Aarhus-University-MPE/ArcticRover/(threads)

Thread 1 (2022-06-20):

Battery Overheated/Chemical Smell

MadsR, 2022-06-20:
### ArcticRover firmware version

0.97.037

### Area(s) with issue?

Hardware Issue, Batteries

### Steps to reproduce

Rover was hot, heating element was disconnected.
Tried maneuvering rover with remote control, unresponsive, assumed low battery.
Left Rover in the sun throughout day, to presumably charge batteries.
Returned later in the day, batteries hot, and a chemical smell inside the box.

### ✔️ Expected Behavior

_No response_

### ❌ Actual Behavior

_No response_

grinsted, 2022-06-23:
Would an off the shelf solar charge controller prevent the issue in future?

MadsR, 2022-06-24:
**Solar Charge Controller**
Any controller capable to handling "single cell" charging should suffice.
Regualr LiPo chargers require individual cell measurements to charge.

Battery manufacturer stated that such a Battery Management System (BMS) would not at all be necessary, and could in worst case make the system perform worse (efficiency, etc.).

This primary error would not happen if the Rover was active (move until low battery -> halt until high -> move until low).
This is only due to having full capactiy and continuously charging.

---

**Potential Solution 1**
Add external power draw (power resistor) once batteries reach 100%, to avoid overcharging batteries.

**Notes**
Power Resistor has to be dimensioned sufficiently to not overheat.
Can be used as a means of 'clearing snow' around Rover while idle.

---

**Potential Solution 2**
Add Solar Charge Controller..

**Notes**
As stated can potentially reduce efficiency.

---

**Potential Solution 3**
Wire solar panels through ON/OFF switch, to avoid charging batteries while system is Idle

**Notes**
Can cause solar panels to overheat as well if they have no way to dissipate generated power.  (Add bypass Power Resistor when disconnected)

grinsted, 2022-07-05:
We configured a morningstar TS-45 to work with the NiMH voltages we used. This has resolved the issue. The configuration should be optimized for the cells.

Thoughts: The morningstar can be configured to dump excess solar energy into a dump load that could heat the interior. (We did not do this as it would probably get too hot unless there is some temperature control too.

Potential issue: NiMH cells have a very flat voltage vs charge% curve. This makes it more important to allow for temperature effects on all voltage thresholds. -Both those configured in the charge controller, but perhaps also those in the arduino code.

Thread 2 (2022-06-24):

Motor Error 20 & 28

MadsR, 2022-06-24:
### ArcticRover firmware version

0.97.07

### Area(s) with issue?

Hardware Issue

### Steps to reproduce

Enable motor driver power, Enable motor Primary power.

### ✔️ Expected Behavior

Motors report error 28 (Undervoltage error) until internal capacity is sufficiently high. Then no error reports.

### ❌ Actual Behavior

One motor continuously report error 20 (DCLink error) and error 28 (undervoltage error) continuously.

Previously this eror was documented after a motor stress test, only after returning the motor for a service did this error dissapear.

MadsR, 2022-06-24:
Replacing faulty motor with backup motor resolved the issue.

**Todo**
Send all motors to manufacturer to resolve this unwanted behavior.

grinsted, 2022-07-05:
Originally this error was reported by the left motor. Now the right motor also reports the same error. The day prior to this we experienced the motor stalling when the wheel sunk into soft snow. So perhaps this is somewhat similar to the stress test in that we asked it to do something more than it could deliver with the rated torque.

One more symptom: I have noticed that the motor does hum a bit and makes some tiny jerks while it reports this error. I recorded a video of this behaviour.

Thread 3 (2022-07-05):

RF loss

grinsted, 2022-07-05:
### ArcticRover firmware version

_No response_

### Area(s) with issue?

Remote Control

### Steps to reproduce

RF losses are very frequent. It is not practical to drive the rover more than ~20m away because you know you have to go press the select button.

### ✔️ Expected Behavior

I would like the rover to keep the RF connection even if there are errors. I  would like that the rover attempts to re-establish the connection even if the connection is lost.

### ❌ Actual Behavior

Lots of RF losses.
This could possibly be because whenever other errors occur (e.g. motor error), then the rover disconnects from RF. I am not sure.

Thread 4 (2022-07-05):

Traction and wheel size

grinsted, 2022-07-05:
### ArcticRover firmware version

_No response_

### Area(s) with issue?

Hardware Issue

### Steps to reproduce

The current alu wheels are 20cm wide and have Ø32 (excluding the L-profiles). These wheels have too little traction in soft snow.

My gut feeling is that the contact area should be a factor 4 greater.

Idea: Compare the weight to contact area to many existing snow vehicles to get an indication if dimensioning is off.

### ✔️ Expected Behavior

Good traction under a wide range of snow conditions.

### ❌ Actual Behavior

The wheels dig into the snow as soon as the surface is not hard and compacted.

grinsted, 2022-07-05:
Tried wrapping the wheels in a snowmobile belt. This increased the width to 50cm, and the diameter by a small amount. This seems to have much better traction in soft snow, but we then experienced stalling errors from the motors.

Thread 6 (2022-07-05):

plugs instead of wires through box

grinsted, 2022-07-05:
### Description of the new feature / enhancement

Plugs on the wall of the rover instead of wires feeding through.

### Scenario when this would be used?

It would help with the following issues:

* Reducing cold bridges to the outside.
* Fewer sources of error when assembling
* Less stress on cables.

### Supporting information

_No response_

MadsR, 2022-07-18:
I assume this primarily refers to the motor cables. This was discussed during initial development, but due to snow/water, sealing, feedthrough cables were used in the initial design.

I agree for both assembly and cable stress, having surface connectors is ideal.

Thread 7 (2022-07-05):

Alternative to DB9 connectors

grinsted, 2022-07-05:
### Description of the new feature / enhancement

The DB9 connectors, and the black DB9 extension cables are not safely secured inside the grey box. Also there is too little space between them. It is near impossible to connect the PCAN connector when a motor cable is connected.

I would prefer a ribbon cable or something like that going from the board to the plug on the greybox, instead of the short DB9 extension cables inside the box.

### Scenario when this would be used?

The DB9 extension cables are only loosely connected. THis means that these connections are a constant source of worry and questioning whenever there is some error.

### Supporting information

_No response_

Thread 8 (2022-07-05):

Heartbeat race condition

grinsted, 2022-07-05:
### ArcticRover firmware version

_No response_

### Area(s) with issue?

General

### Steps to reproduce

I have not experienced this issue, but i believe this to be a bug.

Lets imagine that heartbeat link between the two arduinos is broken. This means that neither will get heartbeats and they will both attempt to reset each other. There is no predicting which comes first. If the nano wins, then you could imagine it would keep winning if it takes any time at all for the mega to startup, because the nano will have a headstart on its timer.

### ✔️ Expected Behavior

n/a

### ❌ Actual Behavior

n/a

Thread 9 (2022-07-05):

timing using millis

grinsted, 2022-07-05:
### ArcticRover firmware version

_No response_

### Area(s) with issue?

Other

### Steps to reproduce

This is not an error we have yet experienced, so i describe the bug here.

Millis is an integer counter that wraps resets to zero after ~42 days (i believe). When it wraps around comparisons such as this wont behave as extpected.

```c
void HeatingProcess()
{
  if (millis() - lastMillisTempCheck < TEMP_CHECK_PERIOD)
    return;
```

In this particular place it could actually be critical as this will mean that the heating will "never" turn off.

### ✔️ Expected Behavior

n/a

### ❌ Actual Behavior

n/a

grinsted, 2022-07-05:
This code may actually be fine according to: https://arduino.stackexchange.com/questions/12587/how-can-i-handle-the-millis-rollover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,you%20are%20doing%20something%20wrong.

Atleast if all the types in the comparison are "unsigned longs".  In the above snippet is a long instead of an unsigned long. I dont know what effect that has. -Should be tested.
