Aarhus-University-MPE/ArcticRover/src/arduino/Output/preproc/ctags_target_for_gcc_minus_e.cpp

# 1 "d:\\Projects\\ArcticRover\\src\\arduino\\_Mainframe\\_Mainframe.ino"
/*

  GeoRover mainframe - Manages primary systems as the Rover backbone.



  Mads Rosenhøj Jeppesen

  Aarhus University

  2022

*/
# 9 "d:\\Projects\\ArcticRover\\src\\arduino\\_Mainframe\\_Mainframe.ino"
# 10 "d:\\Projects\\ArcticRover\\src\\arduino\\_Mainframe\\_Mainframe.ino" 2
# 11 "d:\\Projects\\ArcticRover\\src\\arduino\\_Mainframe\\_Mainframe.ino" 2
# 12 "d:\\Projects\\ArcticRover\\src\\arduino\\_Mainframe\\_Mainframe.ino" 2

// ------------------------------------------------------------ //
//                            SETUP                             //
// ------------------------------------------------------------ //
void setup() {
  // System initialization
  InitAllPins();
  InitButtons();
  InitStatusLed();

  // Debug
  initializeDebugComm();

  SetStatus(false);

  SystemEnablePrimary();

  // Strategy initialization
  InitStrategyMethods();
  InitMode();
}

// ------------------------------------------------------------ //
//                          MAIN LOOP                           //
// ------------------------------------------------------------ //
void loop() {
  ModeUpdater();

  strategyMethods[1][mode]();

  HeartBeat();

  // IridiumProcess();

  recvWithStartEndMarkers();
  PerformCommand();
}
# 1 "d:\\Projects\\ArcticRover\\src\\arduino\\_Mainframe\\Com_CanBus.ino"
/*

  GeoRover CanBUS communication protocols for openCAN communication (Motors)

  https://github.com/autowp/arduino-mcp2515



  Mads Rosenhøj Jeppesen

  Aarhus University

  2022

*/
# 12 "d:\\Projects\\ArcticRover\\src\\arduino\\_Mainframe\\Com_CanBus.ino"
struct can_frame canMsg;
struct can_frame canTestMsg;

long CanBusTxLast;

int canTestState = 0;
long millisCanTestStart = 0;
long millisLastCanPrint = 0;

MCP2515 mcp2515(26 /* 50 (MISO), 51 (MOSI), 52 (SCK)*/);

bool InitializeCanBus() {
  int err;

  digitalWrite(34 /* Enables CAN power, Motor HW Enable and Motor Driver Power*/, true);
  delay(5);

  SPI.begin(); // Begins SPI communication
  mcp2515.reset();

  err = mcp2515.setBitrate(CAN_125KBPS, MCP_8MHZ);
  if (err != MCP2515::ERROR_OK) return false;

  err = mcp2515.setNormalMode();
  if (err != MCP2515::ERROR_OK) return false;

  motorRight.ResetCanStatus();
  motorLeft.SetCanTxStatus();

  bool status = true;

  return status;
}

void TerminateCanBus() {
  SPI.end();
  digitalWrite(34 /* Enables CAN power, Motor HW Enable and Motor Driver Power*/, false);
}

/*

  TX Period:

    MotorL TX -> RX

    ->

    MotorR TX -> RX

    ->

    Repeat

*/
# 60 "d:\\Projects\\ArcticRover\\src\\arduino\\_Mainframe\\Com_CanBus.ino"
void CanBusPrint() {
  if (millis() - millisLastCanPrint < 1000) {
    return;
  }
  millisLastCanPrint = millis();

  bool motorLeftStatus = motorLeft.PrintStatus();
  bool motorRightStatus = motorRight.PrintStatus();

  // status = motorLeftStatus || motorRightStatus;

  // printChannels();
  Serial.println((reinterpret_cast<const __FlashStringHelper *>(
# 72 "d:\\Projects\\ArcticRover\\src\\arduino\\_Mainframe\\Com_CanBus.ino" 3
                (__extension__({static const char __c[] __attribute__((__progmem__)) = (
# 72 "d:\\Projects\\ArcticRover\\src\\arduino\\_Mainframe\\Com_CanBus.ino"
                "-------------------------------"
# 72 "d:\\Projects\\ArcticRover\\src\\arduino\\_Mainframe\\Com_CanBus.ino" 3
                ); &__c[0];}))
# 72 "d:\\Projects\\ArcticRover\\src\\arduino\\_Mainframe\\Com_CanBus.ino"
                )));
}

// Process CANbus commands, returns false if MCP2515 throws error
bool CanBusProcess() {
  if (millis() - CanBusTxLast < 10) {
    return true;
  }

  int err;
  if (motorLeft.GetCanTxStatus()) {
    err = mcp2515.sendMessage(motorLeft.GetCanMsg());
    if (err != MCP2515::ERROR_OK) {
      BlackBoxAppend((reinterpret_cast<const __FlashStringHelper *>(
# 85 "d:\\Projects\\ArcticRover\\src\\arduino\\_Mainframe\\Com_CanBus.ino" 3
     (__extension__({static const char __c[] __attribute__((__progmem__)) = (
# 85 "d:\\Projects\\ArcticRover\\src\\arduino\\_Mainframe\\Com_CanBus.ino"
     "Can Error Left: "
# 85 "d:\\Projects\\ArcticRover\\src\\arduino\\_Mainframe\\Com_CanBus.ino" 3
     ); &__c[0];}))
# 85 "d:\\Projects\\ArcticRover\\src\\arduino\\_Mainframe\\Com_CanBus.ino"
     ))); Serial.print((reinterpret_cast<const __FlashStringHelper *>(
# 85 "d:\\Projects\\ArcticRover\\src\\arduino\\_Mainframe\\Com_CanBus.ino" 3
     (__extension__({static const char __c[] __attribute__((__progmem__)) = (
# 85 "d:\\Projects\\ArcticRover\\src\\arduino\\_Mainframe\\Com_CanBus.ino"
     "Can Error Left: "
# 85 "d:\\Projects\\ArcticRover\\src\\arduino\\_Mainframe\\Com_CanBus.ino" 3
     ); &__c[0];}))
# 85 "d:\\Projects\\ArcticRover\\src\\arduino\\_Mainframe\\Com_CanBus.ino"
     )));
      BlackBoxAppendln(err); Serial.println(err);
      return false;
    }
  } else if (motorRight.GetCanTxStatus()) {
    err = mcp2515.sendMessage(motorRight.GetCanMsg());
    if (err != MCP2515::ERROR_OK) {
      BlackBoxAppend((reinterpret_cast<const __FlashStringHelper *>(
# 92 "d:\\Projects\\ArcticRover\\src\\arduino\\_Mainframe\\Com_CanBus.ino" 3
     (__extension__({static const char __c[] __attribute__((__progmem__)) = (
# 92 "d:\\Projects\\ArcticRover\\src\\arduino\\_Mainframe\\Com_CanBus.ino"
     "Can Error Right: "
# 92 "d:\\Projects\\ArcticRover\\src\\arduino\\_Mainframe\\Com_CanBus.ino" 3
     ); &__c[0];}))
# 92 "d:\\Projects\\ArcticRover\\src\\arduino\\_Mainframe\\Com_CanBus.ino"
     ))); Serial.print((reinterpret_cast<const __FlashStringHelper *>(
# 92 "d:\\Projects\\ArcticRover\\src\\arduino\\_Mainframe\\Com_CanBus.ino" 3
     (__extension__({static const char __c[] __attribute__((__progmem__)) = (
# 92 "d:\\Projects\\ArcticRover\\src\\arduino\\_Mainframe\\Com_CanBus.ino"
     "Can Error Right: "
# 92 "d:\\Projects\\ArcticRover\\src\\arduino\\_Mainframe\\Com_CanBus.ino" 3
     ); &__c[0];}))
# 92 "d:\\Projects\\ArcticRover\\src\\arduino\\_Mainframe\\Com_CanBus.ino"
     )));
      BlackBoxAppendln(err); Serial.println(err);
      return false;
    }
  }

  if (motorLeft.GetCanRxStatus() || motorRight.GetCanRxStatus()) {
    if (motorLeft.CheckCanRxTimeout() == GemMotor::CAN_ERROR_TIMEOUT) motorRight.SetCanTxStatus();
    if (motorRight.CheckCanRxTimeout() == GemMotor::CAN_ERROR_TIMEOUT) motorLeft.SetCanTxStatus();

    if (mcp2515.readMessage(&canMsg) == MCP2515::ERROR_OK) {
      ParseData();
    }
  }
  return true;
}

bool CanBusStatus() {
  return GetStatus(9);
}

bool ParseData() {
  char buffer[100];
  bool status = false;

  // Check ID against left motor
  if (canMsg.can_id == 0x64 || canMsg.can_id == 0x64 + 1 || canMsg.can_id == 0x64 + 2 || canMsg.can_id == 0x64 + 3) {
    status = motorLeft.ParseCanMsg(canMsg);
    motorRight.SetCanTxStatus(); // Indicate motor Right to send next msg
  }

  // Check ID against right motor
  else if (canMsg.can_id == 0x74 || canMsg.can_id == 0x74 + 1 || canMsg.can_id == 0x74 + 2 || canMsg.can_id == 0x74 + 3) {
    status = motorRight.ParseCanMsg(canMsg);
    motorLeft.SetCanTxStatus(); // Indicate motor Left to send next msg
  }

  CanBusTxLast = millis();
  return status;
}

bool CanBusTest() {
  bool testDone = false;

  switch (canTestState) {
    case 0:
      BlackBoxAppend((reinterpret_cast<const __FlashStringHelper *>(
# 138 "d:\\Projects\\ArcticRover\\src\\arduino\\_Mainframe\\Com_CanBus.ino" 3
     (__extension__({static const char __c[] __attribute__((__progmem__)) = (
# 138 "d:\\Projects\\ArcticRover\\src\\arduino\\_Mainframe\\Com_CanBus.ino"
     "GNSS feed starting for: "
# 138 "d:\\Projects\\ArcticRover\\src\\arduino\\_Mainframe\\Com_CanBus.ino" 3
     ); &__c[0];}))
# 138 "d:\\Projects\\ArcticRover\\src\\arduino\\_Mainframe\\Com_CanBus.ino"
     ))); Serial.print((reinterpret_cast<const __FlashStringHelper *>(
# 138 "d:\\Projects\\ArcticRover\\src\\arduino\\_Mainframe\\Com_CanBus.ino" 3
     (__extension__({static const char __c[] __attribute__((__progmem__)) = (
# 138 "d:\\Projects\\ArcticRover\\src\\arduino\\_Mainframe\\Com_CanBus.ino"
     "GNSS feed starting for: "
# 138 "d:\\Projects\\ArcticRover\\src\\arduino\\_Mainframe\\Com_CanBus.ino" 3
     ); &__c[0];}))
# 138 "d:\\Projects\\ArcticRover\\src\\arduino\\_Mainframe\\Com_CanBus.ino"
     )));
      BlackBoxAppend(30000); Serial.print(30000);
      BlackBoxAppendln((reinterpret_cast<const __FlashStringHelper *>(
# 140 "d:\\Projects\\ArcticRover\\src\\arduino\\_Mainframe\\Com_CanBus.ino" 3
     (__extension__({static const char __c[] __attribute__((__progmem__)) = (
# 140 "d:\\Projects\\ArcticRover\\src\\arduino\\_Mainframe\\Com_CanBus.ino"
     " ms"
# 140 "d:\\Projects\\ArcticRover\\src\\arduino\\_Mainframe\\Com_CanBus.ino" 3
     ); &__c[0];}))
# 140 "d:\\Projects\\ArcticRover\\src\\arduino\\_Mainframe\\Com_CanBus.ino"
     ))); Serial.println((reinterpret_cast<const __FlashStringHelper *>(
# 140 "d:\\Projects\\ArcticRover\\src\\arduino\\_Mainframe\\Com_CanBus.ino" 3
     (__extension__({static const char __c[] __attribute__((__progmem__)) = (
# 140 "d:\\Projects\\ArcticRover\\src\\arduino\\_Mainframe\\Com_CanBus.ino"
     " ms"
# 140 "d:\\Projects\\ArcticRover\\src\\arduino\\_Mainframe\\Com_CanBus.ino" 3
     ); &__c[0];}))
# 140 "d:\\Projects\\ArcticRover\\src\\arduino\\_Mainframe\\Com_CanBus.ino"
     )));
      BlackBoxAppendln((reinterpret_cast<const __FlashStringHelper *>(
# 141 "d:\\Projects\\ArcticRover\\src\\arduino\\_Mainframe\\Com_CanBus.ino" 3
     (__extension__({static const char __c[] __attribute__((__progmem__)) = (
# 141 "d:\\Projects\\ArcticRover\\src\\arduino\\_Mainframe\\Com_CanBus.ino"
     "------------------------------------"
# 141 "d:\\Projects\\ArcticRover\\src\\arduino\\_Mainframe\\Com_CanBus.ino" 3
     ); &__c[0];}))
# 141 "d:\\Projects\\ArcticRover\\src\\arduino\\_Mainframe\\Com_CanBus.ino"
     ))); Serial.println((reinterpret_cast<const __FlashStringHelper *>(
# 141 "d:\\Projects\\ArcticRover\\src\\arduino\\_Mainframe\\Com_CanBus.ino" 3
     (__extension__({static const char __c[] __attribute__((__progmem__)) = (
# 141 "d:\\Projects\\ArcticRover\\src\\arduino\\_Mainframe\\Com_CanBus.ino"
     "------------------------------------"
# 141 "d:\\Projects\\ArcticRover\\src\\arduino\\_Mainframe\\Com_CanBus.ino" 3
     ); &__c[0];}))
# 141 "d:\\Projects\\ArcticRover\\src\\arduino\\_Mainframe\\Com_CanBus.ino"
     )));
      BlackBoxAppendln((reinterpret_cast<const __FlashStringHelper *>(
# 142 "d:\\Projects\\ArcticRover\\src\\arduino\\_Mainframe\\Com_CanBus.ino" 3
     (__extension__({static const char __c[] __attribute__((__progmem__)) = (
# 142 "d:\\Projects\\ArcticRover\\src\\arduino\\_Mainframe\\Com_CanBus.ino"
     "------- CAN Read ----------"
# 142 "d:\\Projects\\ArcticRover\\src\\arduino\\_Mainframe\\Com_CanBus.ino" 3
     ); &__c[0];}))
# 142 "d:\\Projects\\ArcticRover\\src\\arduino\\_Mainframe\\Com_CanBus.ino"
     ))); Serial.println((reinterpret_cast<const __FlashStringHelper *>(
# 142 "d:\\Projects\\ArcticRover\\src\\arduino\\_Mainframe\\Com_CanBus.ino" 3
     (__extension__({static const char __c[] __attribute__((__progmem__)) = (
# 142 "d:\\Projects\\ArcticRover\\src\\arduino\\_Mainframe\\Com_CanBus.ino"
     "------- CAN Read ----------"
# 142 "d:\\Projects\\ArcticRover\\src\\arduino\\_Mainframe\\Com_CanBus.ino" 3
     ); &__c[0];}))
# 142 "d:\\Projects\\ArcticRover\\src\\arduino\\_Mainframe\\Com_CanBus.ino"
     )));
      BlackBoxAppendln((reinterpret_cast<const __FlashStringHelper *>(
# 143 "d:\\Projects\\ArcticRover\\src\\arduino\\_Mainframe\\Com_CanBus.ino" 3
     (__extension__({static const char __c[] __attribute__((__progmem__)) = (
# 143 "d:\\Projects\\ArcticRover\\src\\arduino\\_Mainframe\\Com_CanBus.ino"
     "ID  DLC   DATA"
# 143 "d:\\Projects\\ArcticRover\\src\\arduino\\_Mainframe\\Com_CanBus.ino" 3
     ); &__c[0];}))
# 143 "d:\\Projects\\ArcticRover\\src\\arduino\\_Mainframe\\Com_CanBus.ino"
     ))); Serial.println((reinterpret_cast<const __FlashStringHelper *>(
# 143 "d:\\Projects\\ArcticRover\\src\\arduino\\_Mainframe\\Com_CanBus.ino" 3
     (__extension__({static const char __c[] __attribute__((__progmem__)) = (
# 143 "d:\\Projects\\ArcticRover\\src\\arduino\\_Mainframe\\Com_CanBus.ino"
     "ID  DLC   DATA"
# 143 "d:\\Projects\\ArcticRover\\src\\arduino\\_Mainframe\\Com_CanBus.ino" 3
     ); &__c[0];}))
# 143 "d:\\Projects\\ArcticRover\\src\\arduino\\_Mainframe\\Com_CanBus.ino"
     )));
      canTestMsg.can_id = 0x12;
      canTestMsg.can_dlc = 3;
      canTestMsg.data[0] = 0;
      canTestMsg.data[1] = 0;
      canTestMsg.data[2] = 0;
      millisCanTestStart = millis();
      canTestState++;
      break;
    case 1:
      if (millis() - millisLastCanPrint > 10) {
        millisLastCanPrint = millis();
        if (mcp2515.readMessage(&canMsg) == MCP2515::ERROR_OK) {
          StreamData();
          ParseData();
          BlackBoxAppendln(); Serial.println();
        }
        mcp2515.sendMessage(&canTestMsg);
      }

      if (millis() - millisCanTestStart > 30000) canTestState++;
      break;
    case 2:
      canTestState = 0;
      testDone = true;
      SetStatus(9, CanBusStatus()); //<---- Update to reflect Motor CAN Errors
    default:
      break;
  }

  return testDone;
}

// Stream all data in raw HEX
void StreamData() {
  Serial.print(canMsg.can_id, 16); // print ID
  Serial.print((reinterpret_cast<const __FlashStringHelper *>(
# 179 "d:\\Projects\\ArcticRover\\src\\arduino\\_Mainframe\\Com_CanBus.ino" 3
              (__extension__({static const char __c[] __attribute__((__progmem__)) = (
# 179 "d:\\Projects\\ArcticRover\\src\\arduino\\_Mainframe\\Com_CanBus.ino"
              " "
# 179 "d:\\Projects\\ArcticRover\\src\\arduino\\_Mainframe\\Com_CanBus.ino" 3
              ); &__c[0];}))
# 179 "d:\\Projects\\ArcticRover\\src\\arduino\\_Mainframe\\Com_CanBus.ino"
              )));
  Serial.print(canMsg.can_dlc, 16); // print DLC
  Serial.print((reinterpret_cast<const __FlashStringHelper *>(
# 181 "d:\\Projects\\ArcticRover\\src\\arduino\\_Mainframe\\Com_CanBus.ino" 3
              (__extension__({static const char __c[] __attribute__((__progmem__)) = (
# 181 "d:\\Projects\\ArcticRover\\src\\arduino\\_Mainframe\\Com_CanBus.ino"
              " "
# 181 "d:\\Projects\\ArcticRover\\src\\arduino\\_Mainframe\\Com_CanBus.ino" 3
              ); &__c[0];}))
# 181 "d:\\Projects\\ArcticRover\\src\\arduino\\_Mainframe\\Com_CanBus.ino"
              )));

  for (int i = 0; i < canMsg.can_dlc; i++) { // print the data
    Serial.print(canMsg.data[i], 16);
    Serial.print((reinterpret_cast<const __FlashStringHelper *>(
# 185 "d:\\Projects\\ArcticRover\\src\\arduino\\_Mainframe\\Com_CanBus.ino" 3
                (__extension__({static const char __c[] __attribute__((__progmem__)) = (
# 185 "d:\\Projects\\ArcticRover\\src\\arduino\\_Mainframe\\Com_CanBus.ino"
                " "
# 185 "d:\\Projects\\ArcticRover\\src\\arduino\\_Mainframe\\Com_CanBus.ino" 3
                ); &__c[0];}))
# 185 "d:\\Projects\\ArcticRover\\src\\arduino\\_Mainframe\\Com_CanBus.ino"
                )));
  }

  Serial.println();
}

void ParseCanMsg(bool motor) {
  if (canMsg.can_id == 0x64) {
    int control_value = (int)((canMsg.data[1] << 8) | canMsg.data[0]);
    int motor_state = (int)(canMsg.data[3] >> 6);
    int rpm = (int)((canMsg.data[6] << 8) | canMsg.data[5]) / 10.0f;
    int temperature = (int)canMsg.data[7];

    Serial.print((reinterpret_cast<const __FlashStringHelper *>(
# 198 "d:\\Projects\\ArcticRover\\src\\arduino\\_Mainframe\\Com_CanBus.ino" 3
                (__extension__({static const char __c[] __attribute__((__progmem__)) = (
# 198 "d:\\Projects\\ArcticRover\\src\\arduino\\_Mainframe\\Com_CanBus.ino"
                "Control value: "
# 198 "d:\\Projects\\ArcticRover\\src\\arduino\\_Mainframe\\Com_CanBus.ino" 3
                ); &__c[0];}))
# 198 "d:\\Projects\\ArcticRover\\src\\arduino\\_Mainframe\\Com_CanBus.ino"
                )));
    Serial.print(control_value);
    Serial.print((reinterpret_cast<const __FlashStringHelper *>(
# 200 "d:\\Projects\\ArcticRover\\src\\arduino\\_Mainframe\\Com_CanBus.ino" 3
                (__extension__({static const char __c[] __attribute__((__progmem__)) = (
# 200 "d:\\Projects\\ArcticRover\\src\\arduino\\_Mainframe\\Com_CanBus.ino"
                "\t Motor State: "
# 200 "d:\\Projects\\ArcticRover\\src\\arduino\\_Mainframe\\Com_CanBus.ino" 3
                ); &__c[0];}))
# 200 "d:\\Projects\\ArcticRover\\src\\arduino\\_Mainframe\\Com_CanBus.ino"
                )));
    Serial.print(motor_state);
    Serial.print((reinterpret_cast<const __FlashStringHelper *>(
# 202 "d:\\Projects\\ArcticRover\\src\\arduino\\_Mainframe\\Com_CanBus.ino" 3
                (__extension__({static const char __c[] __attribute__((__progmem__)) = (
# 202 "d:\\Projects\\ArcticRover\\src\\arduino\\_Mainframe\\Com_CanBus.ino"
                "\t rpm: "
# 202 "d:\\Projects\\ArcticRover\\src\\arduino\\_Mainframe\\Com_CanBus.ino" 3
                ); &__c[0];}))
# 202 "d:\\Projects\\ArcticRover\\src\\arduino\\_Mainframe\\Com_CanBus.ino"
                )));
    Serial.print(rpm);
    Serial.print((reinterpret_cast<const __FlashStringHelper *>(
# 204 "d:\\Projects\\ArcticRover\\src\\arduino\\_Mainframe\\Com_CanBus.ino" 3
                (__extension__({static const char __c[] __attribute__((__progmem__)) = (
# 204 "d:\\Projects\\ArcticRover\\src\\arduino\\_Mainframe\\Com_CanBus.ino"
                "\t Temperature: "
# 204 "d:\\Projects\\ArcticRover\\src\\arduino\\_Mainframe\\Com_CanBus.ino" 3
                ); &__c[0];}))
# 204 "d:\\Projects\\ArcticRover\\src\\arduino\\_Mainframe\\Com_CanBus.ino"
                )));
    Serial.println(temperature);
  }

  if (canMsg.can_id == 0x65) {
    // inv peak current
    // Motor power
  }

  // Warning
  if (canMsg.can_id == 0x66) {
    bool warning[64];

    for (size_t i = 0; i < 8; i++) {
      for (size_t j = 0; j < 8; j++) {
        warning[i * 8 + j] = canMsg.data[i] >> j & 1;
      }
    }
    Serial.print((reinterpret_cast<const __FlashStringHelper *>(
# 222 "d:\\Projects\\ArcticRover\\src\\arduino\\_Mainframe\\Com_CanBus.ino" 3
                (__extension__({static const char __c[] __attribute__((__progmem__)) = (
# 222 "d:\\Projects\\ArcticRover\\src\\arduino\\_Mainframe\\Com_CanBus.ino"
                "Warning: "
# 222 "d:\\Projects\\ArcticRover\\src\\arduino\\_Mainframe\\Com_CanBus.ino" 3
                ); &__c[0];}))
# 222 "d:\\Projects\\ArcticRover\\src\\arduino\\_Mainframe\\Com_CanBus.ino"
                )));
    for (size_t i = 0; i < 64; i++) {
      if (warning[i] == 1) {
        Serial.print(i);
        Serial.print((reinterpret_cast<const __FlashStringHelper *>(
# 226 "d:\\Projects\\ArcticRover\\src\\arduino\\_Mainframe\\Com_CanBus.ino" 3
                    (__extension__({static const char __c[] __attribute__((__progmem__)) = (
# 226 "d:\\Projects\\ArcticRover\\src\\arduino\\_Mainframe\\Com_CanBus.ino"
                    "\t"
# 226 "d:\\Projects\\ArcticRover\\src\\arduino\\_Mainframe\\Com_CanBus.ino" 3
                    ); &__c[0];}))
# 226 "d:\\Projects\\ArcticRover\\src\\arduino\\_Mainframe\\Com_CanBus.ino"
                    )));
      }
    }

    // for (int i = 0; i<canMsg.can_dlc; i++)  {  // print the data
    //   Serial.print(canMsg.data[i],HEX);
    //   Serial.print(" ");
    // }
    Serial.println();
  }

  // Error
  if (canMsg.can_id == 0x67) {
    bool error[64];

    for (size_t i = 0; i < 8; i++) {
      for (size_t j = 0; j < 8; j++) {
        error[i * 8 + j] = canMsg.data[i] >> j & 1;
      }
    }
    Serial.print((reinterpret_cast<const __FlashStringHelper *>(
# 246 "d:\\Projects\\ArcticRover\\src\\arduino\\_Mainframe\\Com_CanBus.ino" 3
                (__extension__({static const char __c[] __attribute__((__progmem__)) = (
# 246 "d:\\Projects\\ArcticRover\\src\\arduino\\_Mainframe\\Com_CanBus.ino"
                "Error: "
# 246 "d:\\Projects\\ArcticRover\\src\\arduino\\_Mainframe\\Com_CanBus.ino" 3
                ); &__c[0];}))
# 246 "d:\\Projects\\ArcticRover\\src\\arduino\\_Mainframe\\Com_CanBus.ino"
                )));
    for (size_t i = 0; i < 64; i++) {
      if (error[i] == 1) {
        Serial.print(i);
        Serial.print((reinterpret_cast<const __FlashStringHelper *>(
# 250 "d:\\Projects\\ArcticRover\\src\\arduino\\_Mainframe\\Com_CanBus.ino" 3
                    (__extension__({static const char __c[] __attribute__((__progmem__)) = (
# 250 "d:\\Projects\\ArcticRover\\src\\arduino\\_Mainframe\\Com_CanBus.ino"
                    "\t"
# 250 "d:\\Projects\\ArcticRover\\src\\arduino\\_Mainframe\\Com_CanBus.ino" 3
                    ); &__c[0];}))
# 250 "d:\\Projects\\ArcticRover\\src\\arduino\\_Mainframe\\Com_CanBus.ino"
                    )));
      }
    }

    // for (int i = 0; i<canMsg.can_dlc; i++)  {  // print the data
    //   Serial.print(canMsg.data[i],HEX);
    //   Serial.print(" ");
    // }

    Serial.println();
  }
}
# 1 "d:\\Projects\\ArcticRover\\src\\arduino\\_Mainframe\\Com_Iridium.ino"
/*

  GeoRover Iridium communication protocols for long range communication

  using: https://github.com/sparkfun/SparkFun_IridiumSBD_I2C_Arduino_Library



  Mads Rosenhøj Jeppesen

  Aarhus University

  2021

*/
# 10 "d:\\Projects\\ArcticRover\\src\\arduino\\_Mainframe\\Com_Iridium.ino"
# 11 "d:\\Projects\\ArcticRover\\src\\arduino\\_Mainframe\\Com_Iridium.ino" 2


IridiumSBD modem(Serial2 /* 16 (TX), 17 (RX)*/);

uint8_t buffer[200];
int signalQuality = -1;
bool iridiumTxStatus;
unsigned long millisLastIridiumProcess;

bool InitializeIridium() {
  bool status = true;
  Serial2 /* 16 (TX), 17 (RX)*/.begin(19200);

  // modem.setPowerProfile(IridiumSBD::USB_POWER_PROFILE);

  //bool status = (modem.begin() == ISBD_SUCCESS);
  return status;
}

void TerminateIridium() {
  Serial2 /* 16 (TX), 17 (RX)*/.end();
}

bool IridiumStatus() {
  return modem.isConnected();
}

void IridiumProcess() {
  if (!GetStatus(11)) {
    return;
  }

  if (signalQuality < 1) {
    return;
  }

  if (!(millis() - millisLastIridiumProcess > 900000 /* 15 min*/)) {
    return;
  }

  millisLastIridiumProcess = millis();
  IridiumReceive();
  IridiumSend();
}

// Check modem for waiting messages
void IridiumReceive() {
  if (!modem.getWaitingMessageCount() > 0) {
    return;
  }

  int err;
  size_t bufferSize = sizeof(buffer);

  err = modem.sendReceiveSBDText(
# 65 "d:\\Projects\\ArcticRover\\src\\arduino\\_Mainframe\\Com_Iridium.ino" 3 4
                                __null
# 65 "d:\\Projects\\ArcticRover\\src\\arduino\\_Mainframe\\Com_Iridium.ino"
                                    , buffer, bufferSize);
  if (err != 0) {
    BlackBoxAppend((reinterpret_cast<const __FlashStringHelper *>(
# 67 "d:\\Projects\\ArcticRover\\src\\arduino\\_Mainframe\\Com_Iridium.ino" 3
   (__extension__({static const char __c[] __attribute__((__progmem__)) = (
# 67 "d:\\Projects\\ArcticRover\\src\\arduino\\_Mainframe\\Com_Iridium.ino"
   "Receive msg failed, error: "
# 67 "d:\\Projects\\ArcticRover\\src\\arduino\\_Mainframe\\Com_Iridium.ino" 3
   ); &__c[0];}))
# 67 "d:\\Projects\\ArcticRover\\src\\arduino\\_Mainframe\\Com_Iridium.ino"
   ))); Serial.print((reinterpret_cast<const __FlashStringHelper *>(
# 67 "d:\\Projects\\ArcticRover\\src\\arduino\\_Mainframe\\Com_Iridium.ino" 3
   (__extension__({static const char __c[] __attribute__((__progmem__)) = (
# 67 "d:\\Projects\\ArcticRover\\src\\arduino\\_Mainframe\\Com_Iridium.ino"
   "Receive msg failed, error: "
# 67 "d:\\Projects\\ArcticRover\\src\\arduino\\_Mainframe\\Com_Iridium.ino" 3
   ); &__c[0];}))
# 67 "d:\\Projects\\ArcticRover\\src\\arduino\\_Mainframe\\Com_Iridium.ino"
   )));
    BlackBoxAppendln(err); Serial.println(err);
  } else {
    for (int i = 0; i < bufferSize; i++) {
      Serial.print(buffer[i], 16);
      if (isprint(buffer[i])) {
        Serial.print((reinterpret_cast<const __FlashStringHelper *>(
# 73 "d:\\Projects\\ArcticRover\\src\\arduino\\_Mainframe\\Com_Iridium.ino" 3
                    (__extension__({static const char __c[] __attribute__((__progmem__)) = (
# 73 "d:\\Projects\\ArcticRover\\src\\arduino\\_Mainframe\\Com_Iridium.ino"
                    "("
# 73 "d:\\Projects\\ArcticRover\\src\\arduino\\_Mainframe\\Com_Iridium.ino" 3
                    ); &__c[0];}))
# 73 "d:\\Projects\\ArcticRover\\src\\arduino\\_Mainframe\\Com_Iridium.ino"
                    )));
        Serial.write(buffer[i]);
        Serial.print((reinterpret_cast<const __FlashStringHelper *>(
# 75 "d:\\Projects\\ArcticRover\\src\\arduino\\_Mainframe\\Com_Iridium.ino" 3
                    (__extension__({static const char __c[] __attribute__((__progmem__)) = (
# 75 "d:\\Projects\\ArcticRover\\src\\arduino\\_Mainframe\\Com_Iridium.ino"
                    ")"
# 75 "d:\\Projects\\ArcticRover\\src\\arduino\\_Mainframe\\Com_Iridium.ino" 3
                    ); &__c[0];}))
# 75 "d:\\Projects\\ArcticRover\\src\\arduino\\_Mainframe\\Com_Iridium.ino"
                    )));
      }
      Serial.print((reinterpret_cast<const __FlashStringHelper *>(
# 77 "d:\\Projects\\ArcticRover\\src\\arduino\\_Mainframe\\Com_Iridium.ino" 3
                  (__extension__({static const char __c[] __attribute__((__progmem__)) = (
# 77 "d:\\Projects\\ArcticRover\\src\\arduino\\_Mainframe\\Com_Iridium.ino"
                  " "
# 77 "d:\\Projects\\ArcticRover\\src\\arduino\\_Mainframe\\Com_Iridium.ino" 3
                  ); &__c[0];}))
# 77 "d:\\Projects\\ArcticRover\\src\\arduino\\_Mainframe\\Com_Iridium.ino"
                  )));
    }
    Serial.println();
  }
  // Clear the Mobile Originated message buffer to avoid re-sending the message during subsequent loops
  Serial.println((reinterpret_cast<const __FlashStringHelper *>(
# 82 "d:\\Projects\\ArcticRover\\src\\arduino\\_Mainframe\\Com_Iridium.ino" 3
                (__extension__({static const char __c[] __attribute__((__progmem__)) = (
# 82 "d:\\Projects\\ArcticRover\\src\\arduino\\_Mainframe\\Com_Iridium.ino"
                "Clearing the MO buffer."
# 82 "d:\\Projects\\ArcticRover\\src\\arduino\\_Mainframe\\Com_Iridium.ino" 3
                ); &__c[0];}))
# 82 "d:\\Projects\\ArcticRover\\src\\arduino\\_Mainframe\\Com_Iridium.ino"
                )));
  err = modem.clearBuffers(0); // Clear MO buffer
  if (err != 0) {
    Serial.print((reinterpret_cast<const __FlashStringHelper *>(
# 85 "d:\\Projects\\ArcticRover\\src\\arduino\\_Mainframe\\Com_Iridium.ino" 3
                (__extension__({static const char __c[] __attribute__((__progmem__)) = (
# 85 "d:\\Projects\\ArcticRover\\src\\arduino\\_Mainframe\\Com_Iridium.ino"
                "clearBuffers failed, error: "
# 85 "d:\\Projects\\ArcticRover\\src\\arduino\\_Mainframe\\Com_Iridium.ino" 3
                ); &__c[0];}))
# 85 "d:\\Projects\\ArcticRover\\src\\arduino\\_Mainframe\\Com_Iridium.ino"
                )));
    Serial.println(err);
  }
}

// Send iridium message awaiting to be sent
void IridiumSend() {
}

// Full Iridium Test
bool IridiumTest() {
  bool status = true;

  int err = modem.getSignalQuality(signalQuality);
  if (err != 0) {
    status = false;
  }

  BlackBoxAppend((reinterpret_cast<const __FlashStringHelper *>(
# 103 "d:\\Projects\\ArcticRover\\src\\arduino\\_Mainframe\\Com_Iridium.ino" 3
 (__extension__({static const char __c[] __attribute__((__progmem__)) = (
# 103 "d:\\Projects\\ArcticRover\\src\\arduino\\_Mainframe\\Com_Iridium.ino"
 "Iridium: "
# 103 "d:\\Projects\\ArcticRover\\src\\arduino\\_Mainframe\\Com_Iridium.ino" 3
 ); &__c[0];}))
# 103 "d:\\Projects\\ArcticRover\\src\\arduino\\_Mainframe\\Com_Iridium.ino"
 ))); Serial.print((reinterpret_cast<const __FlashStringHelper *>(
# 103 "d:\\Projects\\ArcticRover\\src\\arduino\\_Mainframe\\Com_Iridium.ino" 3
 (__extension__({static const char __c[] __attribute__((__progmem__)) = (
# 103 "d:\\Projects\\ArcticRover\\src\\arduino\\_Mainframe\\Com_Iridium.ino"
 "Iridium: "
# 103 "d:\\Projects\\ArcticRover\\src\\arduino\\_Mainframe\\Com_Iridium.ino" 3
 ); &__c[0];}))
# 103 "d:\\Projects\\ArcticRover\\src\\arduino\\_Mainframe\\Com_Iridium.ino"
 )));
  if (status) {
    BlackBoxAppend((reinterpret_cast<const __FlashStringHelper *>(
# 105 "d:\\Projects\\ArcticRover\\src\\arduino\\_Mainframe\\Com_Iridium.ino" 3
   (__extension__({static const char __c[] __attribute__((__progmem__)) = (
# 105 "d:\\Projects\\ArcticRover\\src\\arduino\\_Mainframe\\Com_Iridium.ino"
   "Signal Quality: "
# 105 "d:\\Projects\\ArcticRover\\src\\arduino\\_Mainframe\\Com_Iridium.ino" 3
   ); &__c[0];}))
# 105 "d:\\Projects\\ArcticRover\\src\\arduino\\_Mainframe\\Com_Iridium.ino"
   ))); Serial.print((reinterpret_cast<const __FlashStringHelper *>(
# 105 "d:\\Projects\\ArcticRover\\src\\arduino\\_Mainframe\\Com_Iridium.ino" 3
   (__extension__({static const char __c[] __attribute__((__progmem__)) = (
# 105 "d:\\Projects\\ArcticRover\\src\\arduino\\_Mainframe\\Com_Iridium.ino"
   "Signal Quality: "
# 105 "d:\\Projects\\ArcticRover\\src\\arduino\\_Mainframe\\Com_Iridium.ino" 3
   ); &__c[0];}))
# 105 "d:\\Projects\\ArcticRover\\src\\arduino\\_Mainframe\\Com_Iridium.ino"
   )));
    BlackBoxAppendln(signalQuality); Serial.println(signalQuality);
  } else {
    BlackBoxAppendln((reinterpret_cast<const __FlashStringHelper *>(
# 108 "d:\\Projects\\ArcticRover\\src\\arduino\\_Mainframe\\Com_Iridium.ino" 3
   (__extension__({static const char __c[] __attribute__((__progmem__)) = (
# 108 "d:\\Projects\\ArcticRover\\src\\arduino\\_Mainframe\\Com_Iridium.ino"
   "ERROR"
# 108 "d:\\Projects\\ArcticRover\\src\\arduino\\_Mainframe\\Com_Iridium.ino" 3
   ); &__c[0];}))
# 108 "d:\\Projects\\ArcticRover\\src\\arduino\\_Mainframe\\Com_Iridium.ino"
   ))); Serial.println((reinterpret_cast<const __FlashStringHelper *>(
# 108 "d:\\Projects\\ArcticRover\\src\\arduino\\_Mainframe\\Com_Iridium.ino" 3
   (__extension__({static const char __c[] __attribute__((__progmem__)) = (
# 108 "d:\\Projects\\ArcticRover\\src\\arduino\\_Mainframe\\Com_Iridium.ino"
   "ERROR"
# 108 "d:\\Projects\\ArcticRover\\src\\arduino\\_Mainframe\\Com_Iridium.ino" 3
   ); &__c[0];}))
# 108 "d:\\Projects\\ArcticRover\\src\\arduino\\_Mainframe\\Com_Iridium.ino"
   )));
  }

  // Example: Print the firmware revision
  char version[12];
  err = modem.getFirmwareVersion(version, sizeof(version));
  if (err != 0) {
    BlackBoxAppend((reinterpret_cast<const __FlashStringHelper *>(
# 115 "d:\\Projects\\ArcticRover\\src\\arduino\\_Mainframe\\Com_Iridium.ino" 3
   (__extension__({static const char __c[] __attribute__((__progmem__)) = (
# 115 "d:\\Projects\\ArcticRover\\src\\arduino\\_Mainframe\\Com_Iridium.ino"
   "Firmware Version failed: error "
# 115 "d:\\Projects\\ArcticRover\\src\\arduino\\_Mainframe\\Com_Iridium.ino" 3
   ); &__c[0];}))
# 115 "d:\\Projects\\ArcticRover\\src\\arduino\\_Mainframe\\Com_Iridium.ino"
   ))); Serial.print((reinterpret_cast<const __FlashStringHelper *>(
# 115 "d:\\Projects\\ArcticRover\\src\\arduino\\_Mainframe\\Com_Iridium.ino" 3
   (__extension__({static const char __c[] __attribute__((__progmem__)) = (
# 115 "d:\\Projects\\ArcticRover\\src\\arduino\\_Mainframe\\Com_Iridium.ino"
   "Firmware Version failed: error "
# 115 "d:\\Projects\\ArcticRover\\src\\arduino\\_Mainframe\\Com_Iridium.ino" 3
   ); &__c[0];}))
# 115 "d:\\Projects\\ArcticRover\\src\\arduino\\_Mainframe\\Com_Iridium.ino"
   )));
    BlackBoxAppendln(err); Serial.println(err);
    status = false;
  }
  BlackBoxAppend((reinterpret_cast<const __FlashStringHelper *>(
# 119 "d:\\Projects\\ArcticRover\\src\\arduino\\_Mainframe\\Com_Iridium.ino" 3
 (__extension__({static const char __c[] __attribute__((__progmem__)) = (
# 119 "d:\\Projects\\ArcticRover\\src\\arduino\\_Mainframe\\Com_Iridium.ino"
 "Firmware Version is "
# 119 "d:\\Projects\\ArcticRover\\src\\arduino\\_Mainframe\\Com_Iridium.ino" 3
 ); &__c[0];}))
# 119 "d:\\Projects\\ArcticRover\\src\\arduino\\_Mainframe\\Com_Iridium.ino"
 ))); Serial.print((reinterpret_cast<const __FlashStringHelper *>(
# 119 "d:\\Projects\\ArcticRover\\src\\arduino\\_Mainframe\\Com_Iridium.ino" 3
 (__extension__({static const char __c[] __attribute__((__progmem__)) = (
# 119 "d:\\Projects\\ArcticRover\\src\\arduino\\_Mainframe\\Com_Iridium.ino"
 "Firmware Version is "
# 119 "d:\\Projects\\ArcticRover\\src\\arduino\\_Mainframe\\Com_Iridium.ino" 3
 ); &__c[0];}))
# 119 "d:\\Projects\\ArcticRover\\src\\arduino\\_Mainframe\\Com_Iridium.ino"
 )));
  BlackBoxAppend(version); Serial.print(version);
  BlackBoxAppendln((reinterpret_cast<const __FlashStringHelper *>(
# 121 "d:\\Projects\\ArcticRover\\src\\arduino\\_Mainframe\\Com_Iridium.ino" 3
 (__extension__({static const char __c[] __attribute__((__progmem__)) = (
# 121 "d:\\Projects\\ArcticRover\\src\\arduino\\_Mainframe\\Com_Iridium.ino"
 "."
# 121 "d:\\Projects\\ArcticRover\\src\\arduino\\_Mainframe\\Com_Iridium.ino" 3
 ); &__c[0];}))
# 121 "d:\\Projects\\ArcticRover\\src\\arduino\\_Mainframe\\Com_Iridium.ino"
 ))); Serial.println((reinterpret_cast<const __FlashStringHelper *>(
# 121 "d:\\Projects\\ArcticRover\\src\\arduino\\_Mainframe\\Com_Iridium.ino" 3
 (__extension__({static const char __c[] __attribute__((__progmem__)) = (
# 121 "d:\\Projects\\ArcticRover\\src\\arduino\\_Mainframe\\Com_Iridium.ino"
 "."
# 121 "d:\\Projects\\ArcticRover\\src\\arduino\\_Mainframe\\Com_Iridium.ino" 3
 ); &__c[0];}))
# 121 "d:\\Projects\\ArcticRover\\src\\arduino\\_Mainframe\\Com_Iridium.ino"
 )));

  // Example: Print the IMEI
  char IMEI[16];
  err = modem.getIMEI(IMEI, sizeof(IMEI));
  if (err != 0) {
    BlackBoxAppend((reinterpret_cast<const __FlashStringHelper *>(
# 127 "d:\\Projects\\ArcticRover\\src\\arduino\\_Mainframe\\Com_Iridium.ino" 3
   (__extension__({static const char __c[] __attribute__((__progmem__)) = (
# 127 "d:\\Projects\\ArcticRover\\src\\arduino\\_Mainframe\\Com_Iridium.ino"
   "getIMEI failed: error "
# 127 "d:\\Projects\\ArcticRover\\src\\arduino\\_Mainframe\\Com_Iridium.ino" 3
   ); &__c[0];}))
# 127 "d:\\Projects\\ArcticRover\\src\\arduino\\_Mainframe\\Com_Iridium.ino"
   ))); Serial.print((reinterpret_cast<const __FlashStringHelper *>(
# 127 "d:\\Projects\\ArcticRover\\src\\arduino\\_Mainframe\\Com_Iridium.ino" 3
   (__extension__({static const char __c[] __attribute__((__progmem__)) = (
# 127 "d:\\Projects\\ArcticRover\\src\\arduino\\_Mainframe\\Com_Iridium.ino"
   "getIMEI failed: error "
# 127 "d:\\Projects\\ArcticRover\\src\\arduino\\_Mainframe\\Com_Iridium.ino" 3
   ); &__c[0];}))
# 127 "d:\\Projects\\ArcticRover\\src\\arduino\\_Mainframe\\Com_Iridium.ino"
   )));
    BlackBoxAppendln(err); Serial.println(err);
    status = false;
  }
  BlackBoxAppend((reinterpret_cast<const __FlashStringHelper *>(
# 131 "d:\\Projects\\ArcticRover\\src\\arduino\\_Mainframe\\Com_Iridium.ino" 3
 (__extension__({static const char __c[] __attribute__((__progmem__)) = (
# 131 "d:\\Projects\\ArcticRover\\src\\arduino\\_Mainframe\\Com_Iridium.ino"
 "IMEI is "
# 131 "d:\\Projects\\ArcticRover\\src\\arduino\\_Mainframe\\Com_Iridium.ino" 3
 ); &__c[0];}))
# 131 "d:\\Projects\\ArcticRover\\src\\arduino\\_Mainframe\\Com_Iridium.ino"
 ))); Serial.print((reinterpret_cast<const __FlashStringHelper *>(
# 131 "d:\\Projects\\ArcticRover\\src\\arduino\\_Mainframe\\Com_Iridium.ino" 3
 (__extension__({static const char __c[] __attribute__((__progmem__)) = (
# 131 "d:\\Projects\\ArcticRover\\src\\arduino\\_Mainframe\\Com_Iridium.ino"
 "IMEI is "
# 131 "d:\\Projects\\ArcticRover\\src\\arduino\\_Mainframe\\Com_Iridium.ino" 3
 ); &__c[0];}))
# 131 "d:\\Projects\\ArcticRover\\src\\arduino\\_Mainframe\\Com_Iridium.ino"
 )));
  BlackBoxAppend(IMEI); Serial.print(IMEI);
  BlackBoxAppendln((reinterpret_cast<const __FlashStringHelper *>(
# 133 "d:\\Projects\\ArcticRover\\src\\arduino\\_Mainframe\\Com_Iridium.ino" 3
 (__extension__({static const char __c[] __attribute__((__progmem__)) = (
# 133 "d:\\Projects\\ArcticRover\\src\\arduino\\_Mainframe\\Com_Iridium.ino"
 "."
# 133 "d:\\Projects\\ArcticRover\\src\\arduino\\_Mainframe\\Com_Iridium.ino" 3
 ); &__c[0];}))
# 133 "d:\\Projects\\ArcticRover\\src\\arduino\\_Mainframe\\Com_Iridium.ino"
 ))); Serial.println((reinterpret_cast<const __FlashStringHelper *>(
# 133 "d:\\Projects\\ArcticRover\\src\\arduino\\_Mainframe\\Com_Iridium.ino" 3
 (__extension__({static const char __c[] __attribute__((__progmem__)) = (
# 133 "d:\\Projects\\ArcticRover\\src\\arduino\\_Mainframe\\Com_Iridium.ino"
 "."
# 133 "d:\\Projects\\ArcticRover\\src\\arduino\\_Mainframe\\Com_Iridium.ino" 3
 ); &__c[0];}))
# 133 "d:\\Projects\\ArcticRover\\src\\arduino\\_Mainframe\\Com_Iridium.ino"
 )));

  // Example: Test the signal quality.
  // This returns a number between 0 and 5.
  // 2 or better is preferred.
  err = modem.getSignalQuality(signalQuality);
  if (err != 0) {
    BlackBoxAppend((reinterpret_cast<const __FlashStringHelper *>(
# 140 "d:\\Projects\\ArcticRover\\src\\arduino\\_Mainframe\\Com_Iridium.ino" 3
   (__extension__({static const char __c[] __attribute__((__progmem__)) = (
# 140 "d:\\Projects\\ArcticRover\\src\\arduino\\_Mainframe\\Com_Iridium.ino"
   "SignalQuality failed: error "
# 140 "d:\\Projects\\ArcticRover\\src\\arduino\\_Mainframe\\Com_Iridium.ino" 3
   ); &__c[0];}))
# 140 "d:\\Projects\\ArcticRover\\src\\arduino\\_Mainframe\\Com_Iridium.ino"
   ))); Serial.print((reinterpret_cast<const __FlashStringHelper *>(
# 140 "d:\\Projects\\ArcticRover\\src\\arduino\\_Mainframe\\Com_Iridium.ino" 3
   (__extension__({static const char __c[] __attribute__((__progmem__)) = (
# 140 "d:\\Projects\\ArcticRover\\src\\arduino\\_Mainframe\\Com_Iridium.ino"
   "SignalQuality failed: error "
# 140 "d:\\Projects\\ArcticRover\\src\\arduino\\_Mainframe\\Com_Iridium.ino" 3
   ); &__c[0];}))
# 140 "d:\\Projects\\ArcticRover\\src\\arduino\\_Mainframe\\Com_Iridium.ino"
   )));
    BlackBoxAppendln(err); Serial.println(err);
    status = false;
  }

  BlackBoxAppend((reinterpret_cast<const __FlashStringHelper *>(
# 145 "d:\\Projects\\ArcticRover\\src\\arduino\\_Mainframe\\Com_Iridium.ino" 3
 (__extension__({static const char __c[] __attribute__((__progmem__)) = (
# 145 "d:\\Projects\\ArcticRover\\src\\arduino\\_Mainframe\\Com_Iridium.ino"
 "On a scale of 0 to 5, signal quality is currently "
# 145 "d:\\Projects\\ArcticRover\\src\\arduino\\_Mainframe\\Com_Iridium.ino" 3
 ); &__c[0];}))
# 145 "d:\\Projects\\ArcticRover\\src\\arduino\\_Mainframe\\Com_Iridium.ino"
 ))); Serial.print((reinterpret_cast<const __FlashStringHelper *>(
# 145 "d:\\Projects\\ArcticRover\\src\\arduino\\_Mainframe\\Com_Iridium.ino" 3
 (__extension__({static const char __c[] __attribute__((__progmem__)) = (
# 145 "d:\\Projects\\ArcticRover\\src\\arduino\\_Mainframe\\Com_Iridium.ino"
 "On a scale of 0 to 5, signal quality is currently "
# 145 "d:\\Projects\\ArcticRover\\src\\arduino\\_Mainframe\\Com_Iridium.ino" 3
 ); &__c[0];}))
# 145 "d:\\Projects\\ArcticRover\\src\\arduino\\_Mainframe\\Com_Iridium.ino"
 )));
  BlackBoxAppend(signalQuality); Serial.print(signalQuality);
  BlackBoxAppendln((reinterpret_cast<const __FlashStringHelper *>(
# 147 "d:\\Projects\\ArcticRover\\src\\arduino\\_Mainframe\\Com_Iridium.ino" 3
 (__extension__({static const char __c[] __attribute__((__progmem__)) = (
# 147 "d:\\Projects\\ArcticRover\\src\\arduino\\_Mainframe\\Com_Iridium.ino"
 "."
# 147 "d:\\Projects\\ArcticRover\\src\\arduino\\_Mainframe\\Com_Iridium.ino" 3
 ); &__c[0];}))
# 147 "d:\\Projects\\ArcticRover\\src\\arduino\\_Mainframe\\Com_Iridium.ino"
 ))); Serial.println((reinterpret_cast<const __FlashStringHelper *>(
# 147 "d:\\Projects\\ArcticRover\\src\\arduino\\_Mainframe\\Com_Iridium.ino" 3
 (__extension__({static const char __c[] __attribute__((__progmem__)) = (
# 147 "d:\\Projects\\ArcticRover\\src\\arduino\\_Mainframe\\Com_Iridium.ino"
 "."
# 147 "d:\\Projects\\ArcticRover\\src\\arduino\\_Mainframe\\Com_Iridium.ino" 3
 ); &__c[0];}))
# 147 "d:\\Projects\\ArcticRover\\src\\arduino\\_Mainframe\\Com_Iridium.ino"
 )));

  BlackBoxAppendln((reinterpret_cast<const __FlashStringHelper *>(
# 149 "d:\\Projects\\ArcticRover\\src\\arduino\\_Mainframe\\Com_Iridium.ino" 3
 (__extension__({static const char __c[] __attribute__((__progmem__)) = (
# 149 "d:\\Projects\\ArcticRover\\src\\arduino\\_Mainframe\\Com_Iridium.ino"
 "------------------------------------"
# 149 "d:\\Projects\\ArcticRover\\src\\arduino\\_Mainframe\\Com_Iridium.ino" 3
 ); &__c[0];}))
# 149 "d:\\Projects\\ArcticRover\\src\\arduino\\_Mainframe\\Com_Iridium.ino"
 ))); Serial.println((reinterpret_cast<const __FlashStringHelper *>(
# 149 "d:\\Projects\\ArcticRover\\src\\arduino\\_Mainframe\\Com_Iridium.ino" 3
 (__extension__({static const char __c[] __attribute__((__progmem__)) = (
# 149 "d:\\Projects\\ArcticRover\\src\\arduino\\_Mainframe\\Com_Iridium.ino"
 "------------------------------------"
# 149 "d:\\Projects\\ArcticRover\\src\\arduino\\_Mainframe\\Com_Iridium.ino" 3
 ); &__c[0];}))
# 149 "d:\\Projects\\ArcticRover\\src\\arduino\\_Mainframe\\Com_Iridium.ino"
 )));

  return status;
}
# 1 "d:\\Projects\\ArcticRover\\src\\arduino\\_Mainframe\\Com_SBus.ino"
/*

  GeoRover SBUS communication protocols for RF communication

  using: https://github.com/zendes/SBUS



  Mads Rosenhøj Jeppesen

  Aarhus University

  2021

*/
# 10 "d:\\Projects\\ArcticRover\\src\\arduino\\_Mainframe\\Com_SBus.ino"
# 11 "d:\\Projects\\ArcticRover\\src\\arduino\\_Mainframe\\Com_SBus.ino" 2

SBUS sbus(Serial3 /* 15 (RX)*/);
bool sBusStatus;
int sbusTestState;
long millisSbusTestStart;
long millisLastSbusPrint;
long millisLastSBusUpdate;

// Initialize RF Communication
bool InitializeSBUS() {
  digitalWrite(44, 0x1);
  sBusStatus = true;

  sbus.begin(false);

  return Serial3 /* 15 (RX)*/;
}

void TerminateSBUS() {
  Serial3 /* 15 (RX)*/.end();
}

bool SBusStatus() {
  return GetStatus(10);
}

bool SBusTest() {
  bool testDone = false;

  switch (sbusTestState) {
    case 0:
      BlackBoxAppend((reinterpret_cast<const __FlashStringHelper *>(
# 42 "d:\\Projects\\ArcticRover\\src\\arduino\\_Mainframe\\Com_SBus.ino" 3
     (__extension__({static const char __c[] __attribute__((__progmem__)) = (
# 42 "d:\\Projects\\ArcticRover\\src\\arduino\\_Mainframe\\Com_SBus.ino"
     "SBUS feed starting for: "
# 42 "d:\\Projects\\ArcticRover\\src\\arduino\\_Mainframe\\Com_SBus.ino" 3
     ); &__c[0];}))
# 42 "d:\\Projects\\ArcticRover\\src\\arduino\\_Mainframe\\Com_SBus.ino"
     ))); Serial.print((reinterpret_cast<const __FlashStringHelper *>(
# 42 "d:\\Projects\\ArcticRover\\src\\arduino\\_Mainframe\\Com_SBus.ino" 3
     (__extension__({static const char __c[] __attribute__((__progmem__)) = (
# 42 "d:\\Projects\\ArcticRover\\src\\arduino\\_Mainframe\\Com_SBus.ino"
     "SBUS feed starting for: "
# 42 "d:\\Projects\\ArcticRover\\src\\arduino\\_Mainframe\\Com_SBus.ino" 3
     ); &__c[0];}))
# 42 "d:\\Projects\\ArcticRover\\src\\arduino\\_Mainframe\\Com_SBus.ino"
     )));
      BlackBoxAppend(10000); Serial.print(10000);
      BlackBoxAppendln((reinterpret_cast<const __FlashStringHelper *>(
# 44 "d:\\Projects\\ArcticRover\\src\\arduino\\_Mainframe\\Com_SBus.ino" 3
     (__extension__({static const char __c[] __attribute__((__progmem__)) = (
# 44 "d:\\Projects\\ArcticRover\\src\\arduino\\_Mainframe\\Com_SBus.ino"
     " ms"
# 44 "d:\\Projects\\ArcticRover\\src\\arduino\\_Mainframe\\Com_SBus.ino" 3
     ); &__c[0];}))
# 44 "d:\\Projects\\ArcticRover\\src\\arduino\\_Mainframe\\Com_SBus.ino"
     ))); Serial.println((reinterpret_cast<const __FlashStringHelper *>(
# 44 "d:\\Projects\\ArcticRover\\src\\arduino\\_Mainframe\\Com_SBus.ino" 3
     (__extension__({static const char __c[] __attribute__((__progmem__)) = (
# 44 "d:\\Projects\\ArcticRover\\src\\arduino\\_Mainframe\\Com_SBus.ino"
     " ms"
# 44 "d:\\Projects\\ArcticRover\\src\\arduino\\_Mainframe\\Com_SBus.ino" 3
     ); &__c[0];}))
# 44 "d:\\Projects\\ArcticRover\\src\\arduino\\_Mainframe\\Com_SBus.ino"
     )));
      millisSbusTestStart = millis();
      sbusTestState++;
      break;
    case 1:
      sbus.process();

      if (millis() - millisLastSbusPrint > 100) {
        millisLastSbusPrint = millis();
        printChannels();
      }

      if (millis() - millisSbusTestStart > 10000) sbusTestState++;
      break;
    case 2:
      sbusTestState = 0;
      testDone = true;
      SetStatus(10, sbus.getGoodFrames() > 0);
      BlackBoxAppendln((reinterpret_cast<const __FlashStringHelper *>(
# 62 "d:\\Projects\\ArcticRover\\src\\arduino\\_Mainframe\\Com_SBus.ino" 3
     (__extension__({static const char __c[] __attribute__((__progmem__)) = (
# 62 "d:\\Projects\\ArcticRover\\src\\arduino\\_Mainframe\\Com_SBus.ino"
     "------------------------------------"
# 62 "d:\\Projects\\ArcticRover\\src\\arduino\\_Mainframe\\Com_SBus.ino" 3
     ); &__c[0];}))
# 62 "d:\\Projects\\ArcticRover\\src\\arduino\\_Mainframe\\Com_SBus.ino"
     ))); Serial.println((reinterpret_cast<const __FlashStringHelper *>(
# 62 "d:\\Projects\\ArcticRover\\src\\arduino\\_Mainframe\\Com_SBus.ino" 3
     (__extension__({static const char __c[] __attribute__((__progmem__)) = (
# 62 "d:\\Projects\\ArcticRover\\src\\arduino\\_Mainframe\\Com_SBus.ino"
     "------------------------------------"
# 62 "d:\\Projects\\ArcticRover\\src\\arduino\\_Mainframe\\Com_SBus.ino" 3
     ); &__c[0];}))
# 62 "d:\\Projects\\ArcticRover\\src\\arduino\\_Mainframe\\Com_SBus.ino"
     )));
    default:
      break;
  }

  return testDone;
}

// Scale SBUS channel value from range [0, 256] to [-1, 1]
float getChannelFloat(int channel) {
  int value = getChannel(channel);

  float valueFloat = value / 128.0 - 1;

  return valueFloat;
}

const int minChannel = -83;
const int maxChannel = 83;
// Scale the S.BUS channel values into the range [0, 256]
int getChannel(int channel) {
  int value = sbus.getNormalizedChannel(channel);

  // if (value < minChannel) {
  //   minChannel = value;
  // }
  // if (value > maxChannel) {
  //   maxChannel = value;
  // }

  float result = value;

  result -= minChannel;
  result /= (maxChannel - minChannel);
  result *= 256;

  return (int)result;
}

// Scale SBUS channel value from range [0, 256] to [-1, 1]
float getChannelFloatFull(int channel) {
  int value = getChannel(channel);

  float valueFloat = value / 256.0;

  return valueFloat;
}

// Read RF signal and update motors accordingly
bool SBusProcess() {
  sbus.process();

  if (millis() - millisLastSBusUpdate < 100) {
    return sBusStatus;
  }
  millisLastSBusUpdate = millis();

  if (getChannel(6) < 200) { // Enable (SF)
    MotorUpdate(0, 0);
    return sBusStatus;
  }

  SBusController();

  // First timeout error returns true (catches large first read getLastTime)
  if (millis() - (unsigned long)sbus.getLastTime() < 2000 && sBusStatus) {
    sBusStatus = false;
    return true;
  } else {
    sBusStatus = true;
  }

  return sBusStatus;
}

// Reads controller input and navigates motors
void SBusController(){
  float throttle1 = getChannelFloatFull(1); // Left stick Vertical
  float dir = getChannelFloat(2); // Right stick Horisontal
  float throttle2 = getChannelFloat(3); // Right stick Vertical
  int gear = getChannel(5); // Gear select (SA)

  int forwardDir;
  float speed;

  // Primary input (Left Stick)
  if (throttle1 > 0.05) {
    if (gear < 50) {
      speed = throttle1 * -1.0f;
    } else if (gear > 200) {
      speed = throttle1;
    } else {
      speed = 0;
    }
    MotorUpdate(dir, speed);
  }
  // Secondary input (Right Stick)
  else if (((throttle2)>0?(throttle2):-(throttle2)) > 0.05 && gear < 200 && gear > 50) {
    if (throttle2 > 0) {
      speed = throttle2 / 2.0f;
    } else {
      speed = throttle2 / 2.0f;
    }
    MotorUpdateTorque(dir, speed);

  } else {
    MotorUpdate(0, 0);
  }
}

void SBusPrint() {
  if (millis() - millisLastSbusPrint < 1000) {
    return;
  }
  millisLastSbusPrint = millis();
  printChannels();
  Serial.println((reinterpret_cast<const __FlashStringHelper *>(
# 178 "d:\\Projects\\ArcticRover\\src\\arduino\\_Mainframe\\Com_SBus.ino" 3
                (__extension__({static const char __c[] __attribute__((__progmem__)) = (
# 178 "d:\\Projects\\ArcticRover\\src\\arduino\\_Mainframe\\Com_SBus.ino"
                "-------------------------------"
# 178 "d:\\Projects\\ArcticRover\\src\\arduino\\_Mainframe\\Com_SBus.ino" 3
                ); &__c[0];}))
# 178 "d:\\Projects\\ArcticRover\\src\\arduino\\_Mainframe\\Com_SBus.ino"
                )));
}

void printChannels() {
  // for (int i = 1; i < 8; i++) {
  //   Serial.print("CH ");
  //   Serial.print(i);
  //   Serial.print(": ");
  //   Serial.print(getChannelFloat(i));
  //   Serial.print("\t");
  // }
  // Serial.println();

  Serial.print("Good frames: ");
  Serial.print(sbus.getGoodFrames());

  Serial.print(" \tData loss on connection: ");
  Serial.print(sbus.getFrameLoss());
  Serial.print("% \t");

  Serial.print("Time diff: ");
  Serial.println(millis() - (unsigned long)sbus.getLastTime());
}

// Timer2 triggers ever 1ms and processes the incoming SBUS datastream
// ISR(TIMER2_COMPA_vect)
// {
//   if(GetStatus(MODULE_RF)) sbus.process();
// }
# 1 "d:\\Projects\\ArcticRover\\src\\arduino\\_Mainframe\\Com_USB.ino"
/*

    USB communication, handles reading serial and parsing commands.



    By

    Mads Rosenhoej Jeppesen - Aarhus 2021

    mrj@mpe.au.dk



    Query data from Drill Logger SD card

*/
# 11 "d:\\Projects\\ArcticRover\\src\\arduino\\_Mainframe\\Com_USB.ino"
const byte numChars = 32;
char receivedCMD[numChars];
int moduleSlct;

void initializeDebugComm() {
  Serial.begin(115200);
  if (Serial /* USB*/)
    SetStatus(17, true);
  else
    SetStatus(17, false);

  BlackBoxAppendln((reinterpret_cast<const __FlashStringHelper *>(
# 22 "d:\\Projects\\ArcticRover\\src\\arduino\\_Mainframe\\Com_USB.ino" 3
 (__extension__({static const char __c[] __attribute__((__progmem__)) = (
# 22 "d:\\Projects\\ArcticRover\\src\\arduino\\_Mainframe\\Com_USB.ino"
 "#---------------------------#"
# 22 "d:\\Projects\\ArcticRover\\src\\arduino\\_Mainframe\\Com_USB.ino" 3
 ); &__c[0];}))
# 22 "d:\\Projects\\ArcticRover\\src\\arduino\\_Mainframe\\Com_USB.ino"
 ))); Serial.println((reinterpret_cast<const __FlashStringHelper *>(
# 22 "d:\\Projects\\ArcticRover\\src\\arduino\\_Mainframe\\Com_USB.ino" 3
 (__extension__({static const char __c[] __attribute__((__progmem__)) = (
# 22 "d:\\Projects\\ArcticRover\\src\\arduino\\_Mainframe\\Com_USB.ino"
 "#---------------------------#"
# 22 "d:\\Projects\\ArcticRover\\src\\arduino\\_Mainframe\\Com_USB.ino" 3
 ); &__c[0];}))
# 22 "d:\\Projects\\ArcticRover\\src\\arduino\\_Mainframe\\Com_USB.ino"
 )));
  BlackBoxAppendln((reinterpret_cast<const __FlashStringHelper *>(
# 23 "d:\\Projects\\ArcticRover\\src\\arduino\\_Mainframe\\Com_USB.ino" 3
 (__extension__({static const char __c[] __attribute__((__progmem__)) = (
# 23 "d:\\Projects\\ArcticRover\\src\\arduino\\_Mainframe\\Com_USB.ino"
 "#     GeoRover Firmware     #"
# 23 "d:\\Projects\\ArcticRover\\src\\arduino\\_Mainframe\\Com_USB.ino" 3
 ); &__c[0];}))
# 23 "d:\\Projects\\ArcticRover\\src\\arduino\\_Mainframe\\Com_USB.ino"
 ))); Serial.println((reinterpret_cast<const __FlashStringHelper *>(
# 23 "d:\\Projects\\ArcticRover\\src\\arduino\\_Mainframe\\Com_USB.ino" 3
 (__extension__({static const char __c[] __attribute__((__progmem__)) = (
# 23 "d:\\Projects\\ArcticRover\\src\\arduino\\_Mainframe\\Com_USB.ino"
 "#     GeoRover Firmware     #"
# 23 "d:\\Projects\\ArcticRover\\src\\arduino\\_Mainframe\\Com_USB.ino" 3
 ); &__c[0];}))
# 23 "d:\\Projects\\ArcticRover\\src\\arduino\\_Mainframe\\Com_USB.ino"
 )));
  BlackBoxAppendln((reinterpret_cast<const __FlashStringHelper *>(
# 24 "d:\\Projects\\ArcticRover\\src\\arduino\\_Mainframe\\Com_USB.ino" 3
 (__extension__({static const char __c[] __attribute__((__progmem__)) = (
# 24 "d:\\Projects\\ArcticRover\\src\\arduino\\_Mainframe\\Com_USB.ino"
 "#       #DEBUG MODE#        #"
# 24 "d:\\Projects\\ArcticRover\\src\\arduino\\_Mainframe\\Com_USB.ino" 3
 ); &__c[0];}))
# 24 "d:\\Projects\\ArcticRover\\src\\arduino\\_Mainframe\\Com_USB.ino"
 ))); Serial.println((reinterpret_cast<const __FlashStringHelper *>(
# 24 "d:\\Projects\\ArcticRover\\src\\arduino\\_Mainframe\\Com_USB.ino" 3
 (__extension__({static const char __c[] __attribute__((__progmem__)) = (
# 24 "d:\\Projects\\ArcticRover\\src\\arduino\\_Mainframe\\Com_USB.ino"
 "#       #DEBUG MODE#        #"
# 24 "d:\\Projects\\ArcticRover\\src\\arduino\\_Mainframe\\Com_USB.ino" 3
 ); &__c[0];}))
# 24 "d:\\Projects\\ArcticRover\\src\\arduino\\_Mainframe\\Com_USB.ino"
 )));
  BlackBoxAppend((reinterpret_cast<const __FlashStringHelper *>(
# 25 "d:\\Projects\\ArcticRover\\src\\arduino\\_Mainframe\\Com_USB.ino" 3
 (__extension__({static const char __c[] __attribute__((__progmem__)) = (
# 25 "d:\\Projects\\ArcticRover\\src\\arduino\\_Mainframe\\Com_USB.ino"
 "#  System Version: "
# 25 "d:\\Projects\\ArcticRover\\src\\arduino\\_Mainframe\\Com_USB.ino" 3
 ); &__c[0];}))
# 25 "d:\\Projects\\ArcticRover\\src\\arduino\\_Mainframe\\Com_USB.ino"
 ))); Serial.print((reinterpret_cast<const __FlashStringHelper *>(
# 25 "d:\\Projects\\ArcticRover\\src\\arduino\\_Mainframe\\Com_USB.ino" 3
 (__extension__({static const char __c[] __attribute__((__progmem__)) = (
# 25 "d:\\Projects\\ArcticRover\\src\\arduino\\_Mainframe\\Com_USB.ino"
 "#  System Version: "
# 25 "d:\\Projects\\ArcticRover\\src\\arduino\\_Mainframe\\Com_USB.ino" 3
 ); &__c[0];}))
# 25 "d:\\Projects\\ArcticRover\\src\\arduino\\_Mainframe\\Com_USB.ino"
 )));
  BlackBoxAppend("0.91.126"); Serial.print("0.91.126");
  BlackBoxAppendln((reinterpret_cast<const __FlashStringHelper *>(
# 27 "d:\\Projects\\ArcticRover\\src\\arduino\\_Mainframe\\Com_USB.ino" 3
 (__extension__({static const char __c[] __attribute__((__progmem__)) = (
# 27 "d:\\Projects\\ArcticRover\\src\\arduino\\_Mainframe\\Com_USB.ino"
 " #"
# 27 "d:\\Projects\\ArcticRover\\src\\arduino\\_Mainframe\\Com_USB.ino" 3
 ); &__c[0];}))
# 27 "d:\\Projects\\ArcticRover\\src\\arduino\\_Mainframe\\Com_USB.ino"
 ))); Serial.println((reinterpret_cast<const __FlashStringHelper *>(
# 27 "d:\\Projects\\ArcticRover\\src\\arduino\\_Mainframe\\Com_USB.ino" 3
 (__extension__({static const char __c[] __attribute__((__progmem__)) = (
# 27 "d:\\Projects\\ArcticRover\\src\\arduino\\_Mainframe\\Com_USB.ino"
 " #"
# 27 "d:\\Projects\\ArcticRover\\src\\arduino\\_Mainframe\\Com_USB.ino" 3
 ); &__c[0];}))
# 27 "d:\\Projects\\ArcticRover\\src\\arduino\\_Mainframe\\Com_USB.ino"
 )));
  BlackBoxAppendln((reinterpret_cast<const __FlashStringHelper *>(
# 28 "d:\\Projects\\ArcticRover\\src\\arduino\\_Mainframe\\Com_USB.ino" 3
 (__extension__({static const char __c[] __attribute__((__progmem__)) = (
# 28 "d:\\Projects\\ArcticRover\\src\\arduino\\_Mainframe\\Com_USB.ino"
 "#---------------------------#"
# 28 "d:\\Projects\\ArcticRover\\src\\arduino\\_Mainframe\\Com_USB.ino" 3
 ); &__c[0];}))
# 28 "d:\\Projects\\ArcticRover\\src\\arduino\\_Mainframe\\Com_USB.ino"
 ))); Serial.println((reinterpret_cast<const __FlashStringHelper *>(
# 28 "d:\\Projects\\ArcticRover\\src\\arduino\\_Mainframe\\Com_USB.ino" 3
 (__extension__({static const char __c[] __attribute__((__progmem__)) = (
# 28 "d:\\Projects\\ArcticRover\\src\\arduino\\_Mainframe\\Com_USB.ino"
 "#---------------------------#"
# 28 "d:\\Projects\\ArcticRover\\src\\arduino\\_Mainframe\\Com_USB.ino" 3
 ); &__c[0];}))
# 28 "d:\\Projects\\ArcticRover\\src\\arduino\\_Mainframe\\Com_USB.ino"
 )));
  BlackBoxAppendln(); Serial.println();
}

// Receive Commands
void recvWithStartEndMarkers() {
  if (Serial.available() <= 0) {
    return;
  }

  static boolean recvInProgress = false;
  static byte ndx = 0;
  char startMarker = '<';
  char endMarker = '>';
  char rc;

  while (Serial.available() > 0) {
    rc = Serial.read();

    if (recvInProgress == true) {
      if (rc != endMarker) {
        receivedCMD[ndx] = rc;
        ndx++;
        if (ndx >= numChars) {
          ndx = numChars - 1;
        }
      } else {
        receivedCMD[ndx] = '\0'; // terminate the string
        recvInProgress = false;
        ndx = 0;
        parseCommand();
      }
    }

    else if (rc == startMarker) {
      recvInProgress = true;
    }
  }
}

bool activeCommand = false;
void PerformCommand() {
  if (!activeCommand) {
    return;
  }

  SystemTestModule(moduleSlct);
}

bool DebugCommStatus() {
  return Serial /* USB*/;
}

// Parse read Command
void parseCommand() {
  BlackBoxAppend((reinterpret_cast<const __FlashStringHelper *>(
# 83 "d:\\Projects\\ArcticRover\\src\\arduino\\_Mainframe\\Com_USB.ino" 3
 (__extension__({static const char __c[] __attribute__((__progmem__)) = (
# 83 "d:\\Projects\\ArcticRover\\src\\arduino\\_Mainframe\\Com_USB.ino"
 "Received command (DBG_PRT): \""
# 83 "d:\\Projects\\ArcticRover\\src\\arduino\\_Mainframe\\Com_USB.ino" 3
 ); &__c[0];}))
# 83 "d:\\Projects\\ArcticRover\\src\\arduino\\_Mainframe\\Com_USB.ino"
 ))); Serial.print((reinterpret_cast<const __FlashStringHelper *>(
# 83 "d:\\Projects\\ArcticRover\\src\\arduino\\_Mainframe\\Com_USB.ino" 3
 (__extension__({static const char __c[] __attribute__((__progmem__)) = (
# 83 "d:\\Projects\\ArcticRover\\src\\arduino\\_Mainframe\\Com_USB.ino"
 "Received command (DBG_PRT): \""
# 83 "d:\\Projects\\ArcticRover\\src\\arduino\\_Mainframe\\Com_USB.ino" 3
 ); &__c[0];}))
# 83 "d:\\Projects\\ArcticRover\\src\\arduino\\_Mainframe\\Com_USB.ino"
 )));
  BlackBoxAppend(receivedCMD); Serial.print(receivedCMD);
  BlackBoxAppendln((reinterpret_cast<const __FlashStringHelper *>(
# 85 "d:\\Projects\\ArcticRover\\src\\arduino\\_Mainframe\\Com_USB.ino" 3
 (__extension__({static const char __c[] __attribute__((__progmem__)) = (
# 85 "d:\\Projects\\ArcticRover\\src\\arduino\\_Mainframe\\Com_USB.ino"
 "\""
# 85 "d:\\Projects\\ArcticRover\\src\\arduino\\_Mainframe\\Com_USB.ino" 3
 ); &__c[0];}))
# 85 "d:\\Projects\\ArcticRover\\src\\arduino\\_Mainframe\\Com_USB.ino"
 ))); Serial.println((reinterpret_cast<const __FlashStringHelper *>(
# 85 "d:\\Projects\\ArcticRover\\src\\arduino\\_Mainframe\\Com_USB.ino" 3
 (__extension__({static const char __c[] __attribute__((__progmem__)) = (
# 85 "d:\\Projects\\ArcticRover\\src\\arduino\\_Mainframe\\Com_USB.ino"
 "\""
# 85 "d:\\Projects\\ArcticRover\\src\\arduino\\_Mainframe\\Com_USB.ino" 3
 ); &__c[0];}))
# 85 "d:\\Projects\\ArcticRover\\src\\arduino\\_Mainframe\\Com_USB.ino"
 )));

  switch (receivedCMD[0]) {
    case 'F':
      parseCommandFiles();
      break;
    case 'S':
      parseCommandStrategy();
      break;
    case 'B':
      parseCommandBackup();
      break;
    case 'M':
      parseCommandModule();
      break;
    case 'R':
      parseCommandRoute();
      break;
    case '\0':
      break;
    default:
      BlackBoxAppendln((reinterpret_cast<const __FlashStringHelper *>(
# 106 "d:\\Projects\\ArcticRover\\src\\arduino\\_Mainframe\\Com_USB.ino" 3
     (__extension__({static const char __c[] __attribute__((__progmem__)) = (
# 106 "d:\\Projects\\ArcticRover\\src\\arduino\\_Mainframe\\Com_USB.ino"
     "NACK"
# 106 "d:\\Projects\\ArcticRover\\src\\arduino\\_Mainframe\\Com_USB.ino" 3
     ); &__c[0];}))
# 106 "d:\\Projects\\ArcticRover\\src\\arduino\\_Mainframe\\Com_USB.ino"
     ))); Serial.println((reinterpret_cast<const __FlashStringHelper *>(
# 106 "d:\\Projects\\ArcticRover\\src\\arduino\\_Mainframe\\Com_USB.ino" 3
     (__extension__({static const char __c[] __attribute__((__progmem__)) = (
# 106 "d:\\Projects\\ArcticRover\\src\\arduino\\_Mainframe\\Com_USB.ino"
     "NACK"
# 106 "d:\\Projects\\ArcticRover\\src\\arduino\\_Mainframe\\Com_USB.ino" 3
     ); &__c[0];}))
# 106 "d:\\Projects\\ArcticRover\\src\\arduino\\_Mainframe\\Com_USB.ino"
     )));
      break;
  }
}

void parseCommandFiles() {
  char *fileNamePtr = receivedCMD + 2;
  char fileName[numChars] = {0};
  strcpy(fileName, fileNamePtr);

  switch (receivedCMD[1]) {
    case 'L':
      SDQuery();
      break;
    case 'S':
      SDSize(fileName);
      break;
    case 'D':
      SDDownload(fileName);
      break;
    case 'R':
      SDDelete(fileName);
      break;
    case 'B':
      BlackBoxPrint();
      break;
    case 'C':
      BlackBoxClear();
      break;
    case '\0':
      break;
    default:
      BlackBoxAppendln((reinterpret_cast<const __FlashStringHelper *>(
# 138 "d:\\Projects\\ArcticRover\\src\\arduino\\_Mainframe\\Com_USB.ino" 3
     (__extension__({static const char __c[] __attribute__((__progmem__)) = (
# 138 "d:\\Projects\\ArcticRover\\src\\arduino\\_Mainframe\\Com_USB.ino"
     "NACK"
# 138 "d:\\Projects\\ArcticRover\\src\\arduino\\_Mainframe\\Com_USB.ino" 3
     ); &__c[0];}))
# 138 "d:\\Projects\\ArcticRover\\src\\arduino\\_Mainframe\\Com_USB.ino"
     ))); Serial.println((reinterpret_cast<const __FlashStringHelper *>(
# 138 "d:\\Projects\\ArcticRover\\src\\arduino\\_Mainframe\\Com_USB.ino" 3
     (__extension__({static const char __c[] __attribute__((__progmem__)) = (
# 138 "d:\\Projects\\ArcticRover\\src\\arduino\\_Mainframe\\Com_USB.ino"
     "NACK"
# 138 "d:\\Projects\\ArcticRover\\src\\arduino\\_Mainframe\\Com_USB.ino" 3
     ); &__c[0];}))
# 138 "d:\\Projects\\ArcticRover\\src\\arduino\\_Mainframe\\Com_USB.ino"
     )));
      break;
  }
}

void parseCommandStrategy() {
  switch (receivedCMD[1]) {
    case 'S':
      BlackBoxAppend((reinterpret_cast<const __FlashStringHelper *>(
# 146 "d:\\Projects\\ArcticRover\\src\\arduino\\_Mainframe\\Com_USB.ino" 3
     (__extension__({static const char __c[] __attribute__((__progmem__)) = (
# 146 "d:\\Projects\\ArcticRover\\src\\arduino\\_Mainframe\\Com_USB.ino"
     "Manual Strategy Set to: "
# 146 "d:\\Projects\\ArcticRover\\src\\arduino\\_Mainframe\\Com_USB.ino" 3
     ); &__c[0];}))
# 146 "d:\\Projects\\ArcticRover\\src\\arduino\\_Mainframe\\Com_USB.ino"
     ))); Serial.print((reinterpret_cast<const __FlashStringHelper *>(
# 146 "d:\\Projects\\ArcticRover\\src\\arduino\\_Mainframe\\Com_USB.ino" 3
     (__extension__({static const char __c[] __attribute__((__progmem__)) = (
# 146 "d:\\Projects\\ArcticRover\\src\\arduino\\_Mainframe\\Com_USB.ino"
     "Manual Strategy Set to: "
# 146 "d:\\Projects\\ArcticRover\\src\\arduino\\_Mainframe\\Com_USB.ino" 3
     ); &__c[0];}))
# 146 "d:\\Projects\\ArcticRover\\src\\arduino\\_Mainframe\\Com_USB.ino"
     )));
      BlackBoxAppendln((int)(receivedCMD[2] - '0')); Serial.println((int)(receivedCMD[2] - '0'));
      if (!SetMode((int)(receivedCMD[2] - '0')))
        BlackBoxAppendln((reinterpret_cast<const __FlashStringHelper *>(
# 149 "d:\\Projects\\ArcticRover\\src\\arduino\\_Mainframe\\Com_USB.ino" 3
       (__extension__({static const char __c[] __attribute__((__progmem__)) = (
# 149 "d:\\Projects\\ArcticRover\\src\\arduino\\_Mainframe\\Com_USB.ino"
       "Mode not found!"
# 149 "d:\\Projects\\ArcticRover\\src\\arduino\\_Mainframe\\Com_USB.ino" 3
       ); &__c[0];}))
# 149 "d:\\Projects\\ArcticRover\\src\\arduino\\_Mainframe\\Com_USB.ino"
       ))); Serial.println((reinterpret_cast<const __FlashStringHelper *>(
# 149 "d:\\Projects\\ArcticRover\\src\\arduino\\_Mainframe\\Com_USB.ino" 3
       (__extension__({static const char __c[] __attribute__((__progmem__)) = (
# 149 "d:\\Projects\\ArcticRover\\src\\arduino\\_Mainframe\\Com_USB.ino"
       "Mode not found!"
# 149 "d:\\Projects\\ArcticRover\\src\\arduino\\_Mainframe\\Com_USB.ino" 3
       ); &__c[0];}))
# 149 "d:\\Projects\\ArcticRover\\src\\arduino\\_Mainframe\\Com_USB.ino"
       )));
      break;
    case 'F':
      strategyMethods[3][mode]();
      break;
    case 'O':
      // Override
      break;
    case '\0':
      break;
    default:
      BlackBoxAppendln((reinterpret_cast<const __FlashStringHelper *>(
# 160 "d:\\Projects\\ArcticRover\\src\\arduino\\_Mainframe\\Com_USB.ino" 3
     (__extension__({static const char __c[] __attribute__((__progmem__)) = (
# 160 "d:\\Projects\\ArcticRover\\src\\arduino\\_Mainframe\\Com_USB.ino"
     "NACK"
# 160 "d:\\Projects\\ArcticRover\\src\\arduino\\_Mainframe\\Com_USB.ino" 3
     ); &__c[0];}))
# 160 "d:\\Projects\\ArcticRover\\src\\arduino\\_Mainframe\\Com_USB.ino"
     ))); Serial.println((reinterpret_cast<const __FlashStringHelper *>(
# 160 "d:\\Projects\\ArcticRover\\src\\arduino\\_Mainframe\\Com_USB.ino" 3
     (__extension__({static const char __c[] __attribute__((__progmem__)) = (
# 160 "d:\\Projects\\ArcticRover\\src\\arduino\\_Mainframe\\Com_USB.ino"
     "NACK"
# 160 "d:\\Projects\\ArcticRover\\src\\arduino\\_Mainframe\\Com_USB.ino" 3
     ); &__c[0];}))
# 160 "d:\\Projects\\ArcticRover\\src\\arduino\\_Mainframe\\Com_USB.ino"
     )));
      break;
  }
}

void parseCommandBackup() {
  switch (receivedCMD[1]) {
    case 'R':
      BlackBoxAppendln((reinterpret_cast<const __FlashStringHelper *>(
# 168 "d:\\Projects\\ArcticRover\\src\\arduino\\_Mainframe\\Com_USB.ino" 3
     (__extension__({static const char __c[] __attribute__((__progmem__)) = (
# 168 "d:\\Projects\\ArcticRover\\src\\arduino\\_Mainframe\\Com_USB.ino"
     "Manual Reset of Backup System."
# 168 "d:\\Projects\\ArcticRover\\src\\arduino\\_Mainframe\\Com_USB.ino" 3
     ); &__c[0];}))
# 168 "d:\\Projects\\ArcticRover\\src\\arduino\\_Mainframe\\Com_USB.ino"
     ))); Serial.println((reinterpret_cast<const __FlashStringHelper *>(
# 168 "d:\\Projects\\ArcticRover\\src\\arduino\\_Mainframe\\Com_USB.ino" 3
     (__extension__({static const char __c[] __attribute__((__progmem__)) = (
# 168 "d:\\Projects\\ArcticRover\\src\\arduino\\_Mainframe\\Com_USB.ino"
     "Manual Reset of Backup System."
# 168 "d:\\Projects\\ArcticRover\\src\\arduino\\_Mainframe\\Com_USB.ino" 3
     ); &__c[0];}))
# 168 "d:\\Projects\\ArcticRover\\src\\arduino\\_Mainframe\\Com_USB.ino"
     )));
      ResetBackupCPU();
      break;
    case 'S':
      BlackBoxAppend((reinterpret_cast<const __FlashStringHelper *>(
# 172 "d:\\Projects\\ArcticRover\\src\\arduino\\_Mainframe\\Com_USB.ino" 3
     (__extension__({static const char __c[] __attribute__((__progmem__)) = (
# 172 "d:\\Projects\\ArcticRover\\src\\arduino\\_Mainframe\\Com_USB.ino"
     "Backup System Status: "
# 172 "d:\\Projects\\ArcticRover\\src\\arduino\\_Mainframe\\Com_USB.ino" 3
     ); &__c[0];}))
# 172 "d:\\Projects\\ArcticRover\\src\\arduino\\_Mainframe\\Com_USB.ino"
     ))); Serial.print((reinterpret_cast<const __FlashStringHelper *>(
# 172 "d:\\Projects\\ArcticRover\\src\\arduino\\_Mainframe\\Com_USB.ino" 3
     (__extension__({static const char __c[] __attribute__((__progmem__)) = (
# 172 "d:\\Projects\\ArcticRover\\src\\arduino\\_Mainframe\\Com_USB.ino"
     "Backup System Status: "
# 172 "d:\\Projects\\ArcticRover\\src\\arduino\\_Mainframe\\Com_USB.ino" 3
     ); &__c[0];}))
# 172 "d:\\Projects\\ArcticRover\\src\\arduino\\_Mainframe\\Com_USB.ino"
     )));
      BlackBoxAppendln(GetStatus(21)); Serial.println(GetStatus(21));
      break;
    case 'H':
      BlackBoxAppendln((reinterpret_cast<const __FlashStringHelper *>(
# 176 "d:\\Projects\\ArcticRover\\src\\arduino\\_Mainframe\\Com_USB.ino" 3
     (__extension__({static const char __c[] __attribute__((__progmem__)) = (
# 176 "d:\\Projects\\ArcticRover\\src\\arduino\\_Mainframe\\Com_USB.ino"
     "Virtual Heartbeat"
# 176 "d:\\Projects\\ArcticRover\\src\\arduino\\_Mainframe\\Com_USB.ino" 3
     ); &__c[0];}))
# 176 "d:\\Projects\\ArcticRover\\src\\arduino\\_Mainframe\\Com_USB.ino"
     ))); Serial.println((reinterpret_cast<const __FlashStringHelper *>(
# 176 "d:\\Projects\\ArcticRover\\src\\arduino\\_Mainframe\\Com_USB.ino" 3
     (__extension__({static const char __c[] __attribute__((__progmem__)) = (
# 176 "d:\\Projects\\ArcticRover\\src\\arduino\\_Mainframe\\Com_USB.ino"
     "Virtual Heartbeat"
# 176 "d:\\Projects\\ArcticRover\\src\\arduino\\_Mainframe\\Com_USB.ino" 3
     ); &__c[0];}))
# 176 "d:\\Projects\\ArcticRover\\src\\arduino\\_Mainframe\\Com_USB.ino"
     )));
      HeartBeatInInterrupt();
      break;
    case 'F':
      BlackBoxAppendln((reinterpret_cast<const __FlashStringHelper *>(
# 180 "d:\\Projects\\ArcticRover\\src\\arduino\\_Mainframe\\Com_USB.ino" 3
     (__extension__({static const char __c[] __attribute__((__progmem__)) = (
# 180 "d:\\Projects\\ArcticRover\\src\\arduino\\_Mainframe\\Com_USB.ino"
     "Simulating System Halt for 60 sec"
# 180 "d:\\Projects\\ArcticRover\\src\\arduino\\_Mainframe\\Com_USB.ino" 3
     ); &__c[0];}))
# 180 "d:\\Projects\\ArcticRover\\src\\arduino\\_Mainframe\\Com_USB.ino"
     ))); Serial.println((reinterpret_cast<const __FlashStringHelper *>(
# 180 "d:\\Projects\\ArcticRover\\src\\arduino\\_Mainframe\\Com_USB.ino" 3
     (__extension__({static const char __c[] __attribute__((__progmem__)) = (
# 180 "d:\\Projects\\ArcticRover\\src\\arduino\\_Mainframe\\Com_USB.ino"
     "Simulating System Halt for 60 sec"
# 180 "d:\\Projects\\ArcticRover\\src\\arduino\\_Mainframe\\Com_USB.ino" 3
     ); &__c[0];}))
# 180 "d:\\Projects\\ArcticRover\\src\\arduino\\_Mainframe\\Com_USB.ino"
     )));
      delay(60000);
      break;
    case '\0':
      break;
    default:
      BlackBoxAppendln((reinterpret_cast<const __FlashStringHelper *>(
# 186 "d:\\Projects\\ArcticRover\\src\\arduino\\_Mainframe\\Com_USB.ino" 3
     (__extension__({static const char __c[] __attribute__((__progmem__)) = (
# 186 "d:\\Projects\\ArcticRover\\src\\arduino\\_Mainframe\\Com_USB.ino"
     "NACK"
# 186 "d:\\Projects\\ArcticRover\\src\\arduino\\_Mainframe\\Com_USB.ino" 3
     ); &__c[0];}))
# 186 "d:\\Projects\\ArcticRover\\src\\arduino\\_Mainframe\\Com_USB.ino"
     ))); Serial.println((reinterpret_cast<const __FlashStringHelper *>(
# 186 "d:\\Projects\\ArcticRover\\src\\arduino\\_Mainframe\\Com_USB.ino" 3
     (__extension__({static const char __c[] __attribute__((__progmem__)) = (
# 186 "d:\\Projects\\ArcticRover\\src\\arduino\\_Mainframe\\Com_USB.ino"
     "NACK"
# 186 "d:\\Projects\\ArcticRover\\src\\arduino\\_Mainframe\\Com_USB.ino" 3
     ); &__c[0];}))
# 186 "d:\\Projects\\ArcticRover\\src\\arduino\\_Mainframe\\Com_USB.ino"
     )));
      break;
  }
}

void parseCommandModule() {
  char *modulePtr = receivedCMD + 2;
  char moduleChar[numChars] = {0};
  strcpy(moduleChar, modulePtr);

  moduleSlct = atoi(moduleChar);

  switch (receivedCMD[1]) {
    case 'E':
      BlackBoxAppend((reinterpret_cast<const __FlashStringHelper *>(
# 200 "d:\\Projects\\ArcticRover\\src\\arduino\\_Mainframe\\Com_USB.ino" 3
     (__extension__({static const char __c[] __attribute__((__progmem__)) = (
# 200 "d:\\Projects\\ArcticRover\\src\\arduino\\_Mainframe\\Com_USB.ino"
     "Manual Enable of Module: "
# 200 "d:\\Projects\\ArcticRover\\src\\arduino\\_Mainframe\\Com_USB.ino" 3
     ); &__c[0];}))
# 200 "d:\\Projects\\ArcticRover\\src\\arduino\\_Mainframe\\Com_USB.ino"
     ))); Serial.print((reinterpret_cast<const __FlashStringHelper *>(
# 200 "d:\\Projects\\ArcticRover\\src\\arduino\\_Mainframe\\Com_USB.ino" 3
     (__extension__({static const char __c[] __attribute__((__progmem__)) = (
# 200 "d:\\Projects\\ArcticRover\\src\\arduino\\_Mainframe\\Com_USB.ino"
     "Manual Enable of Module: "
# 200 "d:\\Projects\\ArcticRover\\src\\arduino\\_Mainframe\\Com_USB.ino" 3
     ); &__c[0];}))
# 200 "d:\\Projects\\ArcticRover\\src\\arduino\\_Mainframe\\Com_USB.ino"
     )));
      switch (receivedCMD[2]) {
        case '\0':
          BlackBoxAppendln((reinterpret_cast<const __FlashStringHelper *>(
# 203 "d:\\Projects\\ArcticRover\\src\\arduino\\_Mainframe\\Com_USB.ino" 3
         (__extension__({static const char __c[] __attribute__((__progmem__)) = (
# 203 "d:\\Projects\\ArcticRover\\src\\arduino\\_Mainframe\\Com_USB.ino"
         "ALL SYSTEMS"
# 203 "d:\\Projects\\ArcticRover\\src\\arduino\\_Mainframe\\Com_USB.ino" 3
         ); &__c[0];}))
# 203 "d:\\Projects\\ArcticRover\\src\\arduino\\_Mainframe\\Com_USB.ino"
         ))); Serial.println((reinterpret_cast<const __FlashStringHelper *>(
# 203 "d:\\Projects\\ArcticRover\\src\\arduino\\_Mainframe\\Com_USB.ino" 3
         (__extension__({static const char __c[] __attribute__((__progmem__)) = (
# 203 "d:\\Projects\\ArcticRover\\src\\arduino\\_Mainframe\\Com_USB.ino"
         "ALL SYSTEMS"
# 203 "d:\\Projects\\ArcticRover\\src\\arduino\\_Mainframe\\Com_USB.ino" 3
         ); &__c[0];}))
# 203 "d:\\Projects\\ArcticRover\\src\\arduino\\_Mainframe\\Com_USB.ino"
         )));
          break;
        default:
          BlackBoxAppendln(moduleSlct); Serial.println(moduleSlct);
          SystemEnable(moduleSlct);
          break;
      }
      break;
    case 'D':
      BlackBoxAppend((reinterpret_cast<const __FlashStringHelper *>(
# 212 "d:\\Projects\\ArcticRover\\src\\arduino\\_Mainframe\\Com_USB.ino" 3
     (__extension__({static const char __c[] __attribute__((__progmem__)) = (
# 212 "d:\\Projects\\ArcticRover\\src\\arduino\\_Mainframe\\Com_USB.ino"
     "Manual Disable of Module: "
# 212 "d:\\Projects\\ArcticRover\\src\\arduino\\_Mainframe\\Com_USB.ino" 3
     ); &__c[0];}))
# 212 "d:\\Projects\\ArcticRover\\src\\arduino\\_Mainframe\\Com_USB.ino"
     ))); Serial.print((reinterpret_cast<const __FlashStringHelper *>(
# 212 "d:\\Projects\\ArcticRover\\src\\arduino\\_Mainframe\\Com_USB.ino" 3
     (__extension__({static const char __c[] __attribute__((__progmem__)) = (
# 212 "d:\\Projects\\ArcticRover\\src\\arduino\\_Mainframe\\Com_USB.ino"
     "Manual Disable of Module: "
# 212 "d:\\Projects\\ArcticRover\\src\\arduino\\_Mainframe\\Com_USB.ino" 3
     ); &__c[0];}))
# 212 "d:\\Projects\\ArcticRover\\src\\arduino\\_Mainframe\\Com_USB.ino"
     )));
      switch (receivedCMD[2]) {
        case '\0':
          BlackBoxAppendln((reinterpret_cast<const __FlashStringHelper *>(
# 215 "d:\\Projects\\ArcticRover\\src\\arduino\\_Mainframe\\Com_USB.ino" 3
         (__extension__({static const char __c[] __attribute__((__progmem__)) = (
# 215 "d:\\Projects\\ArcticRover\\src\\arduino\\_Mainframe\\Com_USB.ino"
         "ALL SYSTEMS"
# 215 "d:\\Projects\\ArcticRover\\src\\arduino\\_Mainframe\\Com_USB.ino" 3
         ); &__c[0];}))
# 215 "d:\\Projects\\ArcticRover\\src\\arduino\\_Mainframe\\Com_USB.ino"
         ))); Serial.println((reinterpret_cast<const __FlashStringHelper *>(
# 215 "d:\\Projects\\ArcticRover\\src\\arduino\\_Mainframe\\Com_USB.ino" 3
         (__extension__({static const char __c[] __attribute__((__progmem__)) = (
# 215 "d:\\Projects\\ArcticRover\\src\\arduino\\_Mainframe\\Com_USB.ino"
         "ALL SYSTEMS"
# 215 "d:\\Projects\\ArcticRover\\src\\arduino\\_Mainframe\\Com_USB.ino" 3
         ); &__c[0];}))
# 215 "d:\\Projects\\ArcticRover\\src\\arduino\\_Mainframe\\Com_USB.ino"
         )));
          SystemDisable();
          break;
        default:
          BlackBoxAppendln(moduleSlct); Serial.println(moduleSlct);
          SystemDisable(moduleSlct);
          break;
      }
      break;
    case 'O':
      BlackBoxAppend((reinterpret_cast<const __FlashStringHelper *>(
# 225 "d:\\Projects\\ArcticRover\\src\\arduino\\_Mainframe\\Com_USB.ino" 3
     (__extension__({static const char __c[] __attribute__((__progmem__)) = (
# 225 "d:\\Projects\\ArcticRover\\src\\arduino\\_Mainframe\\Com_USB.ino"
     "Manual Override of Module: "
# 225 "d:\\Projects\\ArcticRover\\src\\arduino\\_Mainframe\\Com_USB.ino" 3
     ); &__c[0];}))
# 225 "d:\\Projects\\ArcticRover\\src\\arduino\\_Mainframe\\Com_USB.ino"
     ))); Serial.print((reinterpret_cast<const __FlashStringHelper *>(
# 225 "d:\\Projects\\ArcticRover\\src\\arduino\\_Mainframe\\Com_USB.ino" 3
     (__extension__({static const char __c[] __attribute__((__progmem__)) = (
# 225 "d:\\Projects\\ArcticRover\\src\\arduino\\_Mainframe\\Com_USB.ino"
     "Manual Override of Module: "
# 225 "d:\\Projects\\ArcticRover\\src\\arduino\\_Mainframe\\Com_USB.ino" 3
     ); &__c[0];}))
# 225 "d:\\Projects\\ArcticRover\\src\\arduino\\_Mainframe\\Com_USB.ino"
     )));
      switch (receivedCMD[2]) {
        case '\0':
          BlackBoxAppendln((reinterpret_cast<const __FlashStringHelper *>(
# 228 "d:\\Projects\\ArcticRover\\src\\arduino\\_Mainframe\\Com_USB.ino" 3
         (__extension__({static const char __c[] __attribute__((__progmem__)) = (
# 228 "d:\\Projects\\ArcticRover\\src\\arduino\\_Mainframe\\Com_USB.ino"
         "NACK"
# 228 "d:\\Projects\\ArcticRover\\src\\arduino\\_Mainframe\\Com_USB.ino" 3
         ); &__c[0];}))
# 228 "d:\\Projects\\ArcticRover\\src\\arduino\\_Mainframe\\Com_USB.ino"
         ))); Serial.println((reinterpret_cast<const __FlashStringHelper *>(
# 228 "d:\\Projects\\ArcticRover\\src\\arduino\\_Mainframe\\Com_USB.ino" 3
         (__extension__({static const char __c[] __attribute__((__progmem__)) = (
# 228 "d:\\Projects\\ArcticRover\\src\\arduino\\_Mainframe\\Com_USB.ino"
         "NACK"
# 228 "d:\\Projects\\ArcticRover\\src\\arduino\\_Mainframe\\Com_USB.ino" 3
         ); &__c[0];}))
# 228 "d:\\Projects\\ArcticRover\\src\\arduino\\_Mainframe\\Com_USB.ino"
         )));
          // SystemDisable();
          break;
        default:
          BlackBoxAppend(moduleSlct); Serial.print(moduleSlct);
          BlackBoxAppend((reinterpret_cast<const __FlashStringHelper *>(
# 233 "d:\\Projects\\ArcticRover\\src\\arduino\\_Mainframe\\Com_USB.ino" 3
         (__extension__({static const char __c[] __attribute__((__progmem__)) = (
# 233 "d:\\Projects\\ArcticRover\\src\\arduino\\_Mainframe\\Com_USB.ino"
         "\t"
# 233 "d:\\Projects\\ArcticRover\\src\\arduino\\_Mainframe\\Com_USB.ino" 3
         ); &__c[0];}))
# 233 "d:\\Projects\\ArcticRover\\src\\arduino\\_Mainframe\\Com_USB.ino"
         ))); Serial.print((reinterpret_cast<const __FlashStringHelper *>(
# 233 "d:\\Projects\\ArcticRover\\src\\arduino\\_Mainframe\\Com_USB.ino" 3
         (__extension__({static const char __c[] __attribute__((__progmem__)) = (
# 233 "d:\\Projects\\ArcticRover\\src\\arduino\\_Mainframe\\Com_USB.ino"
         "\t"
# 233 "d:\\Projects\\ArcticRover\\src\\arduino\\_Mainframe\\Com_USB.ino" 3
         ); &__c[0];}))
# 233 "d:\\Projects\\ArcticRover\\src\\arduino\\_Mainframe\\Com_USB.ino"
         )));
          BlackBoxAppendln(((!GetStatus(moduleSlct)) == 1 ? "T" : ((!GetStatus(moduleSlct)) == 0 ? "F" : "Unknown"))); Serial.println(((!GetStatus(moduleSlct)) == 1 ? "T" : ((!GetStatus(moduleSlct)) == 0 ? "F" : "Unknown")));
          SetStatus(moduleSlct, !GetStatus(moduleSlct));
          break;
      }
      break;
    case 'S':
      BlackBoxAppendln((reinterpret_cast<const __FlashStringHelper *>(
# 240 "d:\\Projects\\ArcticRover\\src\\arduino\\_Mainframe\\Com_USB.ino" 3
     (__extension__({static const char __c[] __attribute__((__progmem__)) = (
# 240 "d:\\Projects\\ArcticRover\\src\\arduino\\_Mainframe\\Com_USB.ino"
     "Manual System Status Check"
# 240 "d:\\Projects\\ArcticRover\\src\\arduino\\_Mainframe\\Com_USB.ino" 3
     ); &__c[0];}))
# 240 "d:\\Projects\\ArcticRover\\src\\arduino\\_Mainframe\\Com_USB.ino"
     ))); Serial.println((reinterpret_cast<const __FlashStringHelper *>(
# 240 "d:\\Projects\\ArcticRover\\src\\arduino\\_Mainframe\\Com_USB.ino" 3
     (__extension__({static const char __c[] __attribute__((__progmem__)) = (
# 240 "d:\\Projects\\ArcticRover\\src\\arduino\\_Mainframe\\Com_USB.ino"
     "Manual System Status Check"
# 240 "d:\\Projects\\ArcticRover\\src\\arduino\\_Mainframe\\Com_USB.ino" 3
     ); &__c[0];}))
# 240 "d:\\Projects\\ArcticRover\\src\\arduino\\_Mainframe\\Com_USB.ino"
     )));
      // GetStatus(true);
      BlackBoxAppend((reinterpret_cast<const __FlashStringHelper *>(
# 242 "d:\\Projects\\ArcticRover\\src\\arduino\\_Mainframe\\Com_USB.ino" 3
     (__extension__({static const char __c[] __attribute__((__progmem__)) = (
# 242 "d:\\Projects\\ArcticRover\\src\\arduino\\_Mainframe\\Com_USB.ino"
     "System Status: "
# 242 "d:\\Projects\\ArcticRover\\src\\arduino\\_Mainframe\\Com_USB.ino" 3
     ); &__c[0];}))
# 242 "d:\\Projects\\ArcticRover\\src\\arduino\\_Mainframe\\Com_USB.ino"
     ))); Serial.print((reinterpret_cast<const __FlashStringHelper *>(
# 242 "d:\\Projects\\ArcticRover\\src\\arduino\\_Mainframe\\Com_USB.ino" 3
     (__extension__({static const char __c[] __attribute__((__progmem__)) = (
# 242 "d:\\Projects\\ArcticRover\\src\\arduino\\_Mainframe\\Com_USB.ino"
     "System Status: "
# 242 "d:\\Projects\\ArcticRover\\src\\arduino\\_Mainframe\\Com_USB.ino" 3
     ); &__c[0];}))
# 242 "d:\\Projects\\ArcticRover\\src\\arduino\\_Mainframe\\Com_USB.ino"
     )));
      BlackBoxAppendln(String(ToLong(SystemStatus))); Serial.println(String(ToLong(SystemStatus)));
      break;
    case 'R':
      BlackBoxAppend((reinterpret_cast<const __FlashStringHelper *>(
# 246 "d:\\Projects\\ArcticRover\\src\\arduino\\_Mainframe\\Com_USB.ino" 3
     (__extension__({static const char __c[] __attribute__((__progmem__)) = (
# 246 "d:\\Projects\\ArcticRover\\src\\arduino\\_Mainframe\\Com_USB.ino"
     "Manual System Reset in: "
# 246 "d:\\Projects\\ArcticRover\\src\\arduino\\_Mainframe\\Com_USB.ino" 3
     ); &__c[0];}))
# 246 "d:\\Projects\\ArcticRover\\src\\arduino\\_Mainframe\\Com_USB.ino"
     ))); Serial.print((reinterpret_cast<const __FlashStringHelper *>(
# 246 "d:\\Projects\\ArcticRover\\src\\arduino\\_Mainframe\\Com_USB.ino" 3
     (__extension__({static const char __c[] __attribute__((__progmem__)) = (
# 246 "d:\\Projects\\ArcticRover\\src\\arduino\\_Mainframe\\Com_USB.ino"
     "Manual System Reset in: "
# 246 "d:\\Projects\\ArcticRover\\src\\arduino\\_Mainframe\\Com_USB.ino" 3
     ); &__c[0];}))
# 246 "d:\\Projects\\ArcticRover\\src\\arduino\\_Mainframe\\Com_USB.ino"
     )));
      CountDownPrint();
      systemReset();
      break;
    case 'T':
      BlackBoxAppend((reinterpret_cast<const __FlashStringHelper *>(
# 251 "d:\\Projects\\ArcticRover\\src\\arduino\\_Mainframe\\Com_USB.ino" 3
     (__extension__({static const char __c[] __attribute__((__progmem__)) = (
# 251 "d:\\Projects\\ArcticRover\\src\\arduino\\_Mainframe\\Com_USB.ino"
     "Testing Module: "
# 251 "d:\\Projects\\ArcticRover\\src\\arduino\\_Mainframe\\Com_USB.ino" 3
     ); &__c[0];}))
# 251 "d:\\Projects\\ArcticRover\\src\\arduino\\_Mainframe\\Com_USB.ino"
     ))); Serial.print((reinterpret_cast<const __FlashStringHelper *>(
# 251 "d:\\Projects\\ArcticRover\\src\\arduino\\_Mainframe\\Com_USB.ino" 3
     (__extension__({static const char __c[] __attribute__((__progmem__)) = (
# 251 "d:\\Projects\\ArcticRover\\src\\arduino\\_Mainframe\\Com_USB.ino"
     "Testing Module: "
# 251 "d:\\Projects\\ArcticRover\\src\\arduino\\_Mainframe\\Com_USB.ino" 3
     ); &__c[0];}))
# 251 "d:\\Projects\\ArcticRover\\src\\arduino\\_Mainframe\\Com_USB.ino"
     )));
      BlackBoxAppendln(((moduleSlct) == 0 ? "Primary Power" : ((moduleSlct) == 1 ? "Secondary Power (5V)" : ((moduleSlct) == 2 ? "Secondary Power (12V)" : ((moduleSlct) == 3 ? "Secondary Power (24V)" : ((moduleSlct) == 4 ? "Secondary Power (Motors)" : ((moduleSlct) == 5 ? "Motors" : ((moduleSlct) == 6 ? "Motor Left" : ((moduleSlct) == 7 ? "Motor Right" : ((moduleSlct) == 8 ? "Motor Active" : ((moduleSlct) == 9 ? "CAN-bus" : ((moduleSlct) == 10 ? "Short Range Communication (RF)" : ((moduleSlct) == 11 ? "Long Range Communication (Iridium)" : ((moduleSlct) == 12 ? "Global Navigation Satellite System" : ((moduleSlct) == 13 ? "Accelerometer" : ((moduleSlct) == 14 ? "Local Storage" : ((moduleSlct) == 15 ? "Blackbox" : ((moduleSlct) == 16 ? "Waypoint Route" : ((moduleSlct) == 17 ? "Debug Comm." : ((moduleSlct) == 18 ? "System LED" : ((moduleSlct) == 19 ? "Heating" : ((moduleSlct) == 20 ? "Temperature" : ((moduleSlct) == 21 ? "Backup CPU" : ((moduleSlct) == 22 ? "Emergency Stop" : ((moduleSlct) == 23 ? "Reserved" : ("Unknown")))))))))))))))))))))))))); Serial.println(((moduleSlct) == 0 ? "Primary Power" : ((moduleSlct) == 1 ? "Secondary Power (5V)" : ((moduleSlct) == 2 ? "Secondary Power (12V)" : ((moduleSlct) == 3 ? "Secondary Power (24V)" : ((moduleSlct) == 4 ? "Secondary Power (Motors)" : ((moduleSlct) == 5 ? "Motors" : ((moduleSlct) == 6 ? "Motor Left" : ((moduleSlct) == 7 ? "Motor Right" : ((moduleSlct) == 8 ? "Motor Active" : ((moduleSlct) == 9 ? "CAN-bus" : ((moduleSlct) == 10 ? "Short Range Communication (RF)" : ((moduleSlct) == 11 ? "Long Range Communication (Iridium)" : ((moduleSlct) == 12 ? "Global Navigation Satellite System" : ((moduleSlct) == 13 ? "Accelerometer" : ((moduleSlct) == 14 ? "Local Storage" : ((moduleSlct) == 15 ? "Blackbox" : ((moduleSlct) == 16 ? "Waypoint Route" : ((moduleSlct) == 17 ? "Debug Comm." : ((moduleSlct) == 18 ? "System LED" : ((moduleSlct) == 19 ? "Heating" : ((moduleSlct) == 20 ? "Temperature" : ((moduleSlct) == 21 ? "Backup CPU" : ((moduleSlct) == 22 ? "Emergency Stop" : ((moduleSlct) == 23 ? "Reserved" : ("Unknown"))))))))))))))))))))))))));
      BlackBoxAppendln((reinterpret_cast<const __FlashStringHelper *>(
# 253 "d:\\Projects\\ArcticRover\\src\\arduino\\_Mainframe\\Com_USB.ino" 3
     (__extension__({static const char __c[] __attribute__((__progmem__)) = (
# 253 "d:\\Projects\\ArcticRover\\src\\arduino\\_Mainframe\\Com_USB.ino"
     "------------------------------------"
# 253 "d:\\Projects\\ArcticRover\\src\\arduino\\_Mainframe\\Com_USB.ino" 3
     ); &__c[0];}))
# 253 "d:\\Projects\\ArcticRover\\src\\arduino\\_Mainframe\\Com_USB.ino"
     ))); Serial.println((reinterpret_cast<const __FlashStringHelper *>(
# 253 "d:\\Projects\\ArcticRover\\src\\arduino\\_Mainframe\\Com_USB.ino" 3
     (__extension__({static const char __c[] __attribute__((__progmem__)) = (
# 253 "d:\\Projects\\ArcticRover\\src\\arduino\\_Mainframe\\Com_USB.ino"
     "------------------------------------"
# 253 "d:\\Projects\\ArcticRover\\src\\arduino\\_Mainframe\\Com_USB.ino" 3
     ); &__c[0];}))
# 253 "d:\\Projects\\ArcticRover\\src\\arduino\\_Mainframe\\Com_USB.ino"
     )));
      activeCommand = true;
      break;
    case 'Q':
      BlackBoxAppendln((reinterpret_cast<const __FlashStringHelper *>(
# 257 "d:\\Projects\\ArcticRover\\src\\arduino\\_Mainframe\\Com_USB.ino" 3
     (__extension__({static const char __c[] __attribute__((__progmem__)) = (
# 257 "d:\\Projects\\ArcticRover\\src\\arduino\\_Mainframe\\Com_USB.ino"
     "------------------------------------"
# 257 "d:\\Projects\\ArcticRover\\src\\arduino\\_Mainframe\\Com_USB.ino" 3
     ); &__c[0];}))
# 257 "d:\\Projects\\ArcticRover\\src\\arduino\\_Mainframe\\Com_USB.ino"
     ))); Serial.println((reinterpret_cast<const __FlashStringHelper *>(
# 257 "d:\\Projects\\ArcticRover\\src\\arduino\\_Mainframe\\Com_USB.ino" 3
     (__extension__({static const char __c[] __attribute__((__progmem__)) = (
# 257 "d:\\Projects\\ArcticRover\\src\\arduino\\_Mainframe\\Com_USB.ino"
     "------------------------------------"
# 257 "d:\\Projects\\ArcticRover\\src\\arduino\\_Mainframe\\Com_USB.ino" 3
     ); &__c[0];}))
# 257 "d:\\Projects\\ArcticRover\\src\\arduino\\_Mainframe\\Com_USB.ino"
     )));
      BlackBoxAppendln((reinterpret_cast<const __FlashStringHelper *>(
# 258 "d:\\Projects\\ArcticRover\\src\\arduino\\_Mainframe\\Com_USB.ino" 3
     (__extension__({static const char __c[] __attribute__((__progmem__)) = (
# 258 "d:\\Projects\\ArcticRover\\src\\arduino\\_Mainframe\\Com_USB.ino"
     "Manual System Test Stop"
# 258 "d:\\Projects\\ArcticRover\\src\\arduino\\_Mainframe\\Com_USB.ino" 3
     ); &__c[0];}))
# 258 "d:\\Projects\\ArcticRover\\src\\arduino\\_Mainframe\\Com_USB.ino"
     ))); Serial.println((reinterpret_cast<const __FlashStringHelper *>(
# 258 "d:\\Projects\\ArcticRover\\src\\arduino\\_Mainframe\\Com_USB.ino" 3
     (__extension__({static const char __c[] __attribute__((__progmem__)) = (
# 258 "d:\\Projects\\ArcticRover\\src\\arduino\\_Mainframe\\Com_USB.ino"
     "Manual System Test Stop"
# 258 "d:\\Projects\\ArcticRover\\src\\arduino\\_Mainframe\\Com_USB.ino" 3
     ); &__c[0];}))
# 258 "d:\\Projects\\ArcticRover\\src\\arduino\\_Mainframe\\Com_USB.ino"
     )));
      SystemDisable(moduleSlct);
      BlackBoxAppendln((reinterpret_cast<const __FlashStringHelper *>(
# 260 "d:\\Projects\\ArcticRover\\src\\arduino\\_Mainframe\\Com_USB.ino" 3
     (__extension__({static const char __c[] __attribute__((__progmem__)) = (
# 260 "d:\\Projects\\ArcticRover\\src\\arduino\\_Mainframe\\Com_USB.ino"
     "------------------------------------"
# 260 "d:\\Projects\\ArcticRover\\src\\arduino\\_Mainframe\\Com_USB.ino" 3
     ); &__c[0];}))
# 260 "d:\\Projects\\ArcticRover\\src\\arduino\\_Mainframe\\Com_USB.ino"
     ))); Serial.println((reinterpret_cast<const __FlashStringHelper *>(
# 260 "d:\\Projects\\ArcticRover\\src\\arduino\\_Mainframe\\Com_USB.ino" 3
     (__extension__({static const char __c[] __attribute__((__progmem__)) = (
# 260 "d:\\Projects\\ArcticRover\\src\\arduino\\_Mainframe\\Com_USB.ino"
     "------------------------------------"
# 260 "d:\\Projects\\ArcticRover\\src\\arduino\\_Mainframe\\Com_USB.ino" 3
     ); &__c[0];}))
# 260 "d:\\Projects\\ArcticRover\\src\\arduino\\_Mainframe\\Com_USB.ino"
     )));
      activeCommand = false;
      systemTestState = -1;
      break;
    case '\0':
      break;
    default:
      BlackBoxAppendln((reinterpret_cast<const __FlashStringHelper *>(
# 267 "d:\\Projects\\ArcticRover\\src\\arduino\\_Mainframe\\Com_USB.ino" 3
     (__extension__({static const char __c[] __attribute__((__progmem__)) = (
# 267 "d:\\Projects\\ArcticRover\\src\\arduino\\_Mainframe\\Com_USB.ino"
     "NACK"
# 267 "d:\\Projects\\ArcticRover\\src\\arduino\\_Mainframe\\Com_USB.ino" 3
     ); &__c[0];}))
# 267 "d:\\Projects\\ArcticRover\\src\\arduino\\_Mainframe\\Com_USB.ino"
     ))); Serial.println((reinterpret_cast<const __FlashStringHelper *>(
# 267 "d:\\Projects\\ArcticRover\\src\\arduino\\_Mainframe\\Com_USB.ino" 3
     (__extension__({static const char __c[] __attribute__((__progmem__)) = (
# 267 "d:\\Projects\\ArcticRover\\src\\arduino\\_Mainframe\\Com_USB.ino"
     "NACK"
# 267 "d:\\Projects\\ArcticRover\\src\\arduino\\_Mainframe\\Com_USB.ino" 3
     ); &__c[0];}))
# 267 "d:\\Projects\\ArcticRover\\src\\arduino\\_Mainframe\\Com_USB.ino"
     )));
      break;
  }
}

void parseCommandRoute() {
  char tempChars[numChars];
  char *strtokIndx;
  strcpy(tempChars, receivedCMD);

  long latLong;
  long lonLong;

  strtokIndx = strtok(tempChars, ",");
  strtokIndx = strtok(
# 281 "d:\\Projects\\ArcticRover\\src\\arduino\\_Mainframe\\Com_USB.ino" 3 4
                     __null
# 281 "d:\\Projects\\ArcticRover\\src\\arduino\\_Mainframe\\Com_USB.ino"
                         , ",");
  latLong = atol(strtokIndx);
  strtokIndx = strtok(
# 283 "d:\\Projects\\ArcticRover\\src\\arduino\\_Mainframe\\Com_USB.ino" 3 4
                     __null
# 283 "d:\\Projects\\ArcticRover\\src\\arduino\\_Mainframe\\Com_USB.ino"
                         , ",");
  lonLong = atol(strtokIndx);

  switch (receivedCMD[1]) {
    case 'S':
      // write coordinate
      BlackBoxAppend((reinterpret_cast<const __FlashStringHelper *>(
# 289 "d:\\Projects\\ArcticRover\\src\\arduino\\_Mainframe\\Com_USB.ino" 3
     (__extension__({static const char __c[] __attribute__((__progmem__)) = (
# 289 "d:\\Projects\\ArcticRover\\src\\arduino\\_Mainframe\\Com_USB.ino"
     "Lat: "
# 289 "d:\\Projects\\ArcticRover\\src\\arduino\\_Mainframe\\Com_USB.ino" 3
     ); &__c[0];}))
# 289 "d:\\Projects\\ArcticRover\\src\\arduino\\_Mainframe\\Com_USB.ino"
     ))); Serial.print((reinterpret_cast<const __FlashStringHelper *>(
# 289 "d:\\Projects\\ArcticRover\\src\\arduino\\_Mainframe\\Com_USB.ino" 3
     (__extension__({static const char __c[] __attribute__((__progmem__)) = (
# 289 "d:\\Projects\\ArcticRover\\src\\arduino\\_Mainframe\\Com_USB.ino"
     "Lat: "
# 289 "d:\\Projects\\ArcticRover\\src\\arduino\\_Mainframe\\Com_USB.ino" 3
     ); &__c[0];}))
# 289 "d:\\Projects\\ArcticRover\\src\\arduino\\_Mainframe\\Com_USB.ino"
     )));
      BlackBoxAppend(latLong); Serial.print(latLong);
      BlackBoxAppend((reinterpret_cast<const __FlashStringHelper *>(
# 291 "d:\\Projects\\ArcticRover\\src\\arduino\\_Mainframe\\Com_USB.ino" 3
     (__extension__({static const char __c[] __attribute__((__progmem__)) = (
# 291 "d:\\Projects\\ArcticRover\\src\\arduino\\_Mainframe\\Com_USB.ino"
     " Lon: "
# 291 "d:\\Projects\\ArcticRover\\src\\arduino\\_Mainframe\\Com_USB.ino" 3
     ); &__c[0];}))
# 291 "d:\\Projects\\ArcticRover\\src\\arduino\\_Mainframe\\Com_USB.ino"
     ))); Serial.print((reinterpret_cast<const __FlashStringHelper *>(
# 291 "d:\\Projects\\ArcticRover\\src\\arduino\\_Mainframe\\Com_USB.ino" 3
     (__extension__({static const char __c[] __attribute__((__progmem__)) = (
# 291 "d:\\Projects\\ArcticRover\\src\\arduino\\_Mainframe\\Com_USB.ino"
     " Lon: "
# 291 "d:\\Projects\\ArcticRover\\src\\arduino\\_Mainframe\\Com_USB.ino" 3
     ); &__c[0];}))
# 291 "d:\\Projects\\ArcticRover\\src\\arduino\\_Mainframe\\Com_USB.ino"
     )));
      BlackBoxAppendln(lonLong); Serial.println(lonLong);

      EEPROM.put(1 + 8 + 2 + 2 + 2 + (long)(receivedCMD[2] - '0') * 8, latLong);
      EEPROM.put(1 + 8 + 2 + 2 + 2 + 4 + (long)(receivedCMD[2] - '0') * 8, lonLong);
      break;
    case 'P':
      EEPROM.get(1 + 8 + 2 + 2 + 2 + (long)(receivedCMD[2] - '0') * 8, latLong);
      EEPROM.get(1 + 8 + 2 + 2 + 2 + 4 + (long)(receivedCMD[2] - '0') * 8, lonLong);

      BlackBoxAppend((reinterpret_cast<const __FlashStringHelper *>(
# 301 "d:\\Projects\\ArcticRover\\src\\arduino\\_Mainframe\\Com_USB.ino" 3
     (__extension__({static const char __c[] __attribute__((__progmem__)) = (
# 301 "d:\\Projects\\ArcticRover\\src\\arduino\\_Mainframe\\Com_USB.ino"
     "Lat: "
# 301 "d:\\Projects\\ArcticRover\\src\\arduino\\_Mainframe\\Com_USB.ino" 3
     ); &__c[0];}))
# 301 "d:\\Projects\\ArcticRover\\src\\arduino\\_Mainframe\\Com_USB.ino"
     ))); Serial.print((reinterpret_cast<const __FlashStringHelper *>(
# 301 "d:\\Projects\\ArcticRover\\src\\arduino\\_Mainframe\\Com_USB.ino" 3
     (__extension__({static const char __c[] __attribute__((__progmem__)) = (
# 301 "d:\\Projects\\ArcticRover\\src\\arduino\\_Mainframe\\Com_USB.ino"
     "Lat: "
# 301 "d:\\Projects\\ArcticRover\\src\\arduino\\_Mainframe\\Com_USB.ino" 3
     ); &__c[0];}))
# 301 "d:\\Projects\\ArcticRover\\src\\arduino\\_Mainframe\\Com_USB.ino"
     )));
      BlackBoxAppend(latLong); Serial.print(latLong);
      BlackBoxAppend((reinterpret_cast<const __FlashStringHelper *>(
# 303 "d:\\Projects\\ArcticRover\\src\\arduino\\_Mainframe\\Com_USB.ino" 3
     (__extension__({static const char __c[] __attribute__((__progmem__)) = (
# 303 "d:\\Projects\\ArcticRover\\src\\arduino\\_Mainframe\\Com_USB.ino"
     " Lon: "
# 303 "d:\\Projects\\ArcticRover\\src\\arduino\\_Mainframe\\Com_USB.ino" 3
     ); &__c[0];}))
# 303 "d:\\Projects\\ArcticRover\\src\\arduino\\_Mainframe\\Com_USB.ino"
     ))); Serial.print((reinterpret_cast<const __FlashStringHelper *>(
# 303 "d:\\Projects\\ArcticRover\\src\\arduino\\_Mainframe\\Com_USB.ino" 3
     (__extension__({static const char __c[] __attribute__((__progmem__)) = (
# 303 "d:\\Projects\\ArcticRover\\src\\arduino\\_Mainframe\\Com_USB.ino"
     " Lon: "
# 303 "d:\\Projects\\ArcticRover\\src\\arduino\\_Mainframe\\Com_USB.ino" 3
     ); &__c[0];}))
# 303 "d:\\Projects\\ArcticRover\\src\\arduino\\_Mainframe\\Com_USB.ino"
     )));
      BlackBoxAppendln(lonLong); Serial.println(lonLong);
      break;
    default:
      break;
  }
}

void parseData() { // split the data into its parts

  char *strtokIndx; // this is used by strtok() as an index
}

void CountDownPrint() {
  BlackBoxAppend((reinterpret_cast<const __FlashStringHelper *>(
# 317 "d:\\Projects\\ArcticRover\\src\\arduino\\_Mainframe\\Com_USB.ino" 3
 (__extension__({static const char __c[] __attribute__((__progmem__)) = (
# 317 "d:\\Projects\\ArcticRover\\src\\arduino\\_Mainframe\\Com_USB.ino"
 "3"
# 317 "d:\\Projects\\ArcticRover\\src\\arduino\\_Mainframe\\Com_USB.ino" 3
 ); &__c[0];}))
# 317 "d:\\Projects\\ArcticRover\\src\\arduino\\_Mainframe\\Com_USB.ino"
 ))); Serial.print((reinterpret_cast<const __FlashStringHelper *>(
# 317 "d:\\Projects\\ArcticRover\\src\\arduino\\_Mainframe\\Com_USB.ino" 3
 (__extension__({static const char __c[] __attribute__((__progmem__)) = (
# 317 "d:\\Projects\\ArcticRover\\src\\arduino\\_Mainframe\\Com_USB.ino"
 "3"
# 317 "d:\\Projects\\ArcticRover\\src\\arduino\\_Mainframe\\Com_USB.ino" 3
 ); &__c[0];}))
# 317 "d:\\Projects\\ArcticRover\\src\\arduino\\_Mainframe\\Com_USB.ino"
 )));
  delay(333);
  BlackBoxAppend((reinterpret_cast<const __FlashStringHelper *>(
# 319 "d:\\Projects\\ArcticRover\\src\\arduino\\_Mainframe\\Com_USB.ino" 3
 (__extension__({static const char __c[] __attribute__((__progmem__)) = (
# 319 "d:\\Projects\\ArcticRover\\src\\arduino\\_Mainframe\\Com_USB.ino"
 "."
# 319 "d:\\Projects\\ArcticRover\\src\\arduino\\_Mainframe\\Com_USB.ino" 3
 ); &__c[0];}))
# 319 "d:\\Projects\\ArcticRover\\src\\arduino\\_Mainframe\\Com_USB.ino"
 ))); Serial.print((reinterpret_cast<const __FlashStringHelper *>(
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
  BlackBoxAppend((reinterpret_cast<const __FlashStringHelper *>(
# 329 "d:\\Projects\\ArcticRover\\src\\arduino\\_Mainframe\\Com_USB.ino" 3
 (__extension__({static const char __c[] __attribute__((__progmem__)) = (
# 329 "d:\\Projects\\ArcticRover\\src\\arduino\\_Mainframe\\Com_USB.ino"
 "1"
# 329 "d:\\Projects\\ArcticRover\\src\\arduino\\_Mainframe\\Com_USB.ino" 3
 ); &__c[0];}))
# 329 "d:\\Projects\\ArcticRover\\src\\arduino\\_Mainframe\\Com_USB.ino"
 ))); Serial.print((reinterpret_cast<const __FlashStringHelper *>(
# 329 "d:\\Projects\\ArcticRover\\src\\arduino\\_Mainframe\\Com_USB.ino" 3
 (__extension__({static const char __c[] __attribute__((__progmem__)) = (
# 329 "d:\\Projects\\ArcticRover\\src\\arduino\\_Mainframe\\Com_USB.ino"
 "1"
# 329 "d:\\Projects\\ArcticRover\\src\\arduino\\_Mainframe\\Com_USB.ino" 3
 ); &__c[0];}))
# 329 "d:\\Projects\\ArcticRover\\src\\arduino\\_Mainframe\\Com_USB.ino"
 )));
  delay(333);
  BlackBoxAppend((reinterpret_cast<const __FlashStringHelper *>(
# 331 "d:\\Projects\\ArcticRover\\src\\arduino\\_Mainframe\\Com_USB.ino" 3
 (__extension__({static const char __c[] __attribute__((__progmem__)) = (
# 331 "d:\\Projects\\ArcticRover\\src\\arduino\\_Mainframe\\Com_USB.ino"
 "."
# 331 "d:\\Projects\\ArcticRover\\src\\arduino\\_Mainframe\\Com_USB.ino" 3
 ); &__c[0];}))
# 331 "d:\\Projects\\ArcticRover\\src\\arduino\\_Mainframe\\Com_USB.ino"
 ))); Serial.print((reinterpret_cast<const __FlashStringHelper *>(
# 331 "d:\\Projects\\ArcticRover\\src\\arduino\\_Mainframe\\Com_USB.ino" 3
 (__extension__({static const char __c[] __attribute__((__progmem__)) = (
# 331 "d:\\Projects\\ArcticRover\\src\\arduino\\_Mainframe\\Com_USB.ino"
 "."
# 331 "d:\\Projects\\ArcticRover\\src\\arduino\\_Mainframe\\Com_USB.ino" 3
 ); &__c[0];}))
# 331 "d:\\Projects\\ArcticRover\\src\\arduino\\_Mainframe\\Com_USB.ino"
 )));
  delay(333);
  BlackBoxAppendln((reinterpret_cast<const __FlashStringHelper *>(
# 333 "d:\\Projects\\ArcticRover\\src\\arduino\\_Mainframe\\Com_USB.ino" 3
 (__extension__({static const char __c[] __attribute__((__progmem__)) = (
# 333 "d:\\Projects\\ArcticRover\\src\\arduino\\_Mainframe\\Com_USB.ino"
 ". "
# 333 "d:\\Projects\\ArcticRover\\src\\arduino\\_Mainframe\\Com_USB.ino" 3
 ); &__c[0];}))
# 333 "d:\\Projects\\ArcticRover\\src\\arduino\\_Mainframe\\Com_USB.ino"
 ))); Serial.println((reinterpret_cast<const __FlashStringHelper *>(
# 333 "d:\\Projects\\ArcticRover\\src\\arduino\\_Mainframe\\Com_USB.ino" 3
 (__extension__({static const char __c[] __attribute__((__progmem__)) = (
# 333 "d:\\Projects\\ArcticRover\\src\\arduino\\_Mainframe\\Com_USB.ino"
 ". "
# 333 "d:\\Projects\\ArcticRover\\src\\arduino\\_Mainframe\\Com_USB.ino" 3
 ); &__c[0];}))
# 333 "d:\\Projects\\ArcticRover\\src\\arduino\\_Mainframe\\Com_USB.ino"
 )));
  delay(333);
}
# 1 "d:\\Projects\\ArcticRover\\src\\arduino\\_Mainframe\\Sen_Accel.ino"
/*

  GeoRover Accelerometer functionalities, utilizing the XXXX

  (SparkFun Triple Axis Accelerometer Breakout - MMA8452Q https://www.sparkfun.com/products/12756)



  Primary library used:

    https://github.com/sparkfun/SparkFun_MMA8452Q_Arduino_Library/tree/V_1.1.0



  Mads Rosenhøj Jeppesen

  Aarhus University

  2021

*/
# 13 "d:\\Projects\\ArcticRover\\src\\arduino\\_Mainframe\\Sen_Accel.ino"
# 14 "d:\\Projects\\ArcticRover\\src\\arduino\\_Mainframe\\Sen_Accel.ino" 2

MMA8452Q accel;

int accTestState = 0;
long millisAccTestStart = 0;
long millisLastAccPrint = 0;

bool InitializeAccel() {
  bool status = accel.begin(); // scale +/- 2g and frequency of 1.56 Hz
  accel.setScale(SCALE_2G);
  accel.setDataRate(ODR_12);
  SetStatus(13, status);
  return status;
}

void TerminateAccel() {
  //
}

// accel.read() will update two sets of variables.
// * int's x, y, and z will store the signed 12-bit values
//   read out of the accelerometer.
// * floats cx, cy, and cz will store the calculated
//   acceleration from those 12-bit values. These variables
//   are in units of g's.
void ReadAccel() {
  if (accel.available()) {
    accel.read();
  }
}

bool AccelStatus() {
  if(!GetStatus(13)) return false;

  return accel.cz > 0.8f /* approx 35°*/;
}

bool AccelTest() {
  bool testDone = false;
  switch (accTestState) {
    case 0:
      BlackBoxAppend((reinterpret_cast<const __FlashStringHelper *>(
# 55 "d:\\Projects\\ArcticRover\\src\\arduino\\_Mainframe\\Sen_Accel.ino" 3
     (__extension__({static const char __c[] __attribute__((__progmem__)) = (
# 55 "d:\\Projects\\ArcticRover\\src\\arduino\\_Mainframe\\Sen_Accel.ino"
     "Accelerometer feed starting for: "
# 55 "d:\\Projects\\ArcticRover\\src\\arduino\\_Mainframe\\Sen_Accel.ino" 3
     ); &__c[0];}))
# 55 "d:\\Projects\\ArcticRover\\src\\arduino\\_Mainframe\\Sen_Accel.ino"
     ))); Serial.print((reinterpret_cast<const __FlashStringHelper *>(
# 55 "d:\\Projects\\ArcticRover\\src\\arduino\\_Mainframe\\Sen_Accel.ino" 3
     (__extension__({static const char __c[] __attribute__((__progmem__)) = (
# 55 "d:\\Projects\\ArcticRover\\src\\arduino\\_Mainframe\\Sen_Accel.ino"
     "Accelerometer feed starting for: "
# 55 "d:\\Projects\\ArcticRover\\src\\arduino\\_Mainframe\\Sen_Accel.ino" 3
     ); &__c[0];}))
# 55 "d:\\Projects\\ArcticRover\\src\\arduino\\_Mainframe\\Sen_Accel.ino"
     )));
      BlackBoxAppend(10000); Serial.print(10000);
      BlackBoxAppendln((reinterpret_cast<const __FlashStringHelper *>(
# 57 "d:\\Projects\\ArcticRover\\src\\arduino\\_Mainframe\\Sen_Accel.ino" 3
     (__extension__({static const char __c[] __attribute__((__progmem__)) = (
# 57 "d:\\Projects\\ArcticRover\\src\\arduino\\_Mainframe\\Sen_Accel.ino"
     " ms"
# 57 "d:\\Projects\\ArcticRover\\src\\arduino\\_Mainframe\\Sen_Accel.ino" 3
     ); &__c[0];}))
# 57 "d:\\Projects\\ArcticRover\\src\\arduino\\_Mainframe\\Sen_Accel.ino"
     ))); Serial.println((reinterpret_cast<const __FlashStringHelper *>(
# 57 "d:\\Projects\\ArcticRover\\src\\arduino\\_Mainframe\\Sen_Accel.ino" 3
     (__extension__({static const char __c[] __attribute__((__progmem__)) = (
# 57 "d:\\Projects\\ArcticRover\\src\\arduino\\_Mainframe\\Sen_Accel.ino"
     " ms"
# 57 "d:\\Projects\\ArcticRover\\src\\arduino\\_Mainframe\\Sen_Accel.ino" 3
     ); &__c[0];}))
# 57 "d:\\Projects\\ArcticRover\\src\\arduino\\_Mainframe\\Sen_Accel.ino"
     )));
      millisAccTestStart = millis();
      accTestState++;
      break;
    case 1:
      if (millis() - millisLastAccPrint > 250) {
        millisLastAccPrint = millis();
        BlackBoxAppend((reinterpret_cast<const __FlashStringHelper *>(
# 64 "d:\\Projects\\ArcticRover\\src\\arduino\\_Mainframe\\Sen_Accel.ino" 3
       (__extension__({static const char __c[] __attribute__((__progmem__)) = (
# 64 "d:\\Projects\\ArcticRover\\src\\arduino\\_Mainframe\\Sen_Accel.ino"
       "Accelerometer: "
# 64 "d:\\Projects\\ArcticRover\\src\\arduino\\_Mainframe\\Sen_Accel.ino" 3
       ); &__c[0];}))
# 64 "d:\\Projects\\ArcticRover\\src\\arduino\\_Mainframe\\Sen_Accel.ino"
       ))); Serial.print((reinterpret_cast<const __FlashStringHelper *>(
# 64 "d:\\Projects\\ArcticRover\\src\\arduino\\_Mainframe\\Sen_Accel.ino" 3
       (__extension__({static const char __c[] __attribute__((__progmem__)) = (
# 64 "d:\\Projects\\ArcticRover\\src\\arduino\\_Mainframe\\Sen_Accel.ino"
       "Accelerometer: "
# 64 "d:\\Projects\\ArcticRover\\src\\arduino\\_Mainframe\\Sen_Accel.ino" 3
       ); &__c[0];}))
# 64 "d:\\Projects\\ArcticRover\\src\\arduino\\_Mainframe\\Sen_Accel.ino"
       )));
        if (AccelStatus()) {
          ReadAccel();
          BlackBoxAppend((reinterpret_cast<const __FlashStringHelper *>(
# 67 "d:\\Projects\\ArcticRover\\src\\arduino\\_Mainframe\\Sen_Accel.ino" 3
         (__extension__({static const char __c[] __attribute__((__progmem__)) = (
# 67 "d:\\Projects\\ArcticRover\\src\\arduino\\_Mainframe\\Sen_Accel.ino"
         "x: "
# 67 "d:\\Projects\\ArcticRover\\src\\arduino\\_Mainframe\\Sen_Accel.ino" 3
         ); &__c[0];}))
# 67 "d:\\Projects\\ArcticRover\\src\\arduino\\_Mainframe\\Sen_Accel.ino"
         ))); Serial.print((reinterpret_cast<const __FlashStringHelper *>(
# 67 "d:\\Projects\\ArcticRover\\src\\arduino\\_Mainframe\\Sen_Accel.ino" 3
         (__extension__({static const char __c[] __attribute__((__progmem__)) = (
# 67 "d:\\Projects\\ArcticRover\\src\\arduino\\_Mainframe\\Sen_Accel.ino"
         "x: "
# 67 "d:\\Projects\\ArcticRover\\src\\arduino\\_Mainframe\\Sen_Accel.ino" 3
         ); &__c[0];}))
# 67 "d:\\Projects\\ArcticRover\\src\\arduino\\_Mainframe\\Sen_Accel.ino"
         )));
          BlackBoxAppend((float)accel.cx); Serial.print((float)accel.cx);
          BlackBoxAppend((reinterpret_cast<const __FlashStringHelper *>(
# 69 "d:\\Projects\\ArcticRover\\src\\arduino\\_Mainframe\\Sen_Accel.ino" 3
         (__extension__({static const char __c[] __attribute__((__progmem__)) = (
# 69 "d:\\Projects\\ArcticRover\\src\\arduino\\_Mainframe\\Sen_Accel.ino"
         "\t y: "
# 69 "d:\\Projects\\ArcticRover\\src\\arduino\\_Mainframe\\Sen_Accel.ino" 3
         ); &__c[0];}))
# 69 "d:\\Projects\\ArcticRover\\src\\arduino\\_Mainframe\\Sen_Accel.ino"
         ))); Serial.print((reinterpret_cast<const __FlashStringHelper *>(
# 69 "d:\\Projects\\ArcticRover\\src\\arduino\\_Mainframe\\Sen_Accel.ino" 3
         (__extension__({static const char __c[] __attribute__((__progmem__)) = (
# 69 "d:\\Projects\\ArcticRover\\src\\arduino\\_Mainframe\\Sen_Accel.ino"
         "\t y: "
# 69 "d:\\Projects\\ArcticRover\\src\\arduino\\_Mainframe\\Sen_Accel.ino" 3
         ); &__c[0];}))
# 69 "d:\\Projects\\ArcticRover\\src\\arduino\\_Mainframe\\Sen_Accel.ino"
         )));
          BlackBoxAppend((float)accel.cy); Serial.print((float)accel.cy);
          BlackBoxAppend((reinterpret_cast<const __FlashStringHelper *>(
# 71 "d:\\Projects\\ArcticRover\\src\\arduino\\_Mainframe\\Sen_Accel.ino" 3
         (__extension__({static const char __c[] __attribute__((__progmem__)) = (
# 71 "d:\\Projects\\ArcticRover\\src\\arduino\\_Mainframe\\Sen_Accel.ino"
         "\t z: "
# 71 "d:\\Projects\\ArcticRover\\src\\arduino\\_Mainframe\\Sen_Accel.ino" 3
         ); &__c[0];}))
# 71 "d:\\Projects\\ArcticRover\\src\\arduino\\_Mainframe\\Sen_Accel.ino"
         ))); Serial.print((reinterpret_cast<const __FlashStringHelper *>(
# 71 "d:\\Projects\\ArcticRover\\src\\arduino\\_Mainframe\\Sen_Accel.ino" 3
         (__extension__({static const char __c[] __attribute__((__progmem__)) = (
# 71 "d:\\Projects\\ArcticRover\\src\\arduino\\_Mainframe\\Sen_Accel.ino"
         "\t z: "
# 71 "d:\\Projects\\ArcticRover\\src\\arduino\\_Mainframe\\Sen_Accel.ino" 3
         ); &__c[0];}))
# 71 "d:\\Projects\\ArcticRover\\src\\arduino\\_Mainframe\\Sen_Accel.ino"
         )));
          BlackBoxAppendln((float)accel.cz); Serial.println((float)accel.cz);
        } else {
          BlackBoxAppendln((reinterpret_cast<const __FlashStringHelper *>(
# 74 "d:\\Projects\\ArcticRover\\src\\arduino\\_Mainframe\\Sen_Accel.ino" 3
         (__extension__({static const char __c[] __attribute__((__progmem__)) = (
# 74 "d:\\Projects\\ArcticRover\\src\\arduino\\_Mainframe\\Sen_Accel.ino"
         "ERROR"
# 74 "d:\\Projects\\ArcticRover\\src\\arduino\\_Mainframe\\Sen_Accel.ino" 3
         ); &__c[0];}))
# 74 "d:\\Projects\\ArcticRover\\src\\arduino\\_Mainframe\\Sen_Accel.ino"
         ))); Serial.println((reinterpret_cast<const __FlashStringHelper *>(
# 74 "d:\\Projects\\ArcticRover\\src\\arduino\\_Mainframe\\Sen_Accel.ino" 3
         (__extension__({static const char __c[] __attribute__((__progmem__)) = (
# 74 "d:\\Projects\\ArcticRover\\src\\arduino\\_Mainframe\\Sen_Accel.ino"
         "ERROR"
# 74 "d:\\Projects\\ArcticRover\\src\\arduino\\_Mainframe\\Sen_Accel.ino" 3
         ); &__c[0];}))
# 74 "d:\\Projects\\ArcticRover\\src\\arduino\\_Mainframe\\Sen_Accel.ino"
         )));
        }
      }

      if (millis() - millisAccTestStart > 10000) accTestState++;
      break;
    case 2:
      testDone = true;
      accTestState = 0;
      BlackBoxAppendln((reinterpret_cast<const __FlashStringHelper *>(
# 83 "d:\\Projects\\ArcticRover\\src\\arduino\\_Mainframe\\Sen_Accel.ino" 3
     (__extension__({static const char __c[] __attribute__((__progmem__)) = (
# 83 "d:\\Projects\\ArcticRover\\src\\arduino\\_Mainframe\\Sen_Accel.ino"
     "------------------------------------"
# 83 "d:\\Projects\\ArcticRover\\src\\arduino\\_Mainframe\\Sen_Accel.ino" 3
     ); &__c[0];}))
# 83 "d:\\Projects\\ArcticRover\\src\\arduino\\_Mainframe\\Sen_Accel.ino"
     ))); Serial.println((reinterpret_cast<const __FlashStringHelper *>(
# 83 "d:\\Projects\\ArcticRover\\src\\arduino\\_Mainframe\\Sen_Accel.ino" 3
     (__extension__({static const char __c[] __attribute__((__progmem__)) = (
# 83 "d:\\Projects\\ArcticRover\\src\\arduino\\_Mainframe\\Sen_Accel.ino"
     "------------------------------------"
# 83 "d:\\Projects\\ArcticRover\\src\\arduino\\_Mainframe\\Sen_Accel.ino" 3
     ); &__c[0];}))
# 83 "d:\\Projects\\ArcticRover\\src\\arduino\\_Mainframe\\Sen_Accel.ino"
     )));
    default:
      break;
  }

  return testDone;
}
# 1 "d:\\Projects\\ArcticRover\\src\\arduino\\_Mainframe\\Sen_Gnss.ino"
/*

  GeoRover GNSS functionalities, utilizing the ZED-F9P

  (SparkFun GPS-RTK-SMA Breakout https://www.sparkfun.com/products/16481)



  Primary library used:

    https://github.com/sparkfun/SparkFun_u-blox_GNSS_Arduino_Library



  Mads Rosenhøj Jeppesen

  Aarhus University

  2021

*/
# 13 "d:\\Projects\\ArcticRover\\src\\arduino\\_Mainframe\\Sen_Gnss.ino"
# 14 "d:\\Projects\\ArcticRover\\src\\arduino\\_Mainframe\\Sen_Gnss.ino" 2

SFE_UBLOX_GNSS gnss;

long lastTimeGNSS = 0; // Local timer, limits I2C traffic to u-blox module.

int gnssTestState = 0;
long millisGnssTestStart = 0;
long millisLastGnssPrint = 0;

bool InitializeGnss() {
  Wire.begin();
  bool status = gnss.begin();
  if (status) {
    gnss.setI2COutput(COM_TYPE_UBX); // Set the I2C port to output UBX only (turn off NMEA noise)
    gnss.setVal(UBLOX_CFG_RATE_MEAS, 1000 /* in milliseconds*/); // Set measurement rate to 1000ms (1Hz update rate)
  }
  return status;
}

bool GnssStatus() {
  return gnss.isConnected();
}

// Updates current position and Gnss status
bool GnssUpdate(){
  latCurrent = GnssGetLat();
  lonCurrent = GnssGetLong();
}

bool GnssTest() {
  bool testDone = false;
  switch (gnssTestState) {
    case 0:
      BlackBoxAppend((reinterpret_cast<const __FlashStringHelper *>(
# 47 "d:\\Projects\\ArcticRover\\src\\arduino\\_Mainframe\\Sen_Gnss.ino" 3
     (__extension__({static const char __c[] __attribute__((__progmem__)) = (
# 47 "d:\\Projects\\ArcticRover\\src\\arduino\\_Mainframe\\Sen_Gnss.ino"
     "GNSS feed starting for: "
# 47 "d:\\Projects\\ArcticRover\\src\\arduino\\_Mainframe\\Sen_Gnss.ino" 3
     ); &__c[0];}))
# 47 "d:\\Projects\\ArcticRover\\src\\arduino\\_Mainframe\\Sen_Gnss.ino"
     ))); Serial.print((reinterpret_cast<const __FlashStringHelper *>(
# 47 "d:\\Projects\\ArcticRover\\src\\arduino\\_Mainframe\\Sen_Gnss.ino" 3
     (__extension__({static const char __c[] __attribute__((__progmem__)) = (
# 47 "d:\\Projects\\ArcticRover\\src\\arduino\\_Mainframe\\Sen_Gnss.ino"
     "GNSS feed starting for: "
# 47 "d:\\Projects\\ArcticRover\\src\\arduino\\_Mainframe\\Sen_Gnss.ino" 3
     ); &__c[0];}))
# 47 "d:\\Projects\\ArcticRover\\src\\arduino\\_Mainframe\\Sen_Gnss.ino"
     )));
      BlackBoxAppend(10000); Serial.print(10000);
      BlackBoxAppendln((reinterpret_cast<const __FlashStringHelper *>(
# 49 "d:\\Projects\\ArcticRover\\src\\arduino\\_Mainframe\\Sen_Gnss.ino" 3
     (__extension__({static const char __c[] __attribute__((__progmem__)) = (
# 49 "d:\\Projects\\ArcticRover\\src\\arduino\\_Mainframe\\Sen_Gnss.ino"
     " ms"
# 49 "d:\\Projects\\ArcticRover\\src\\arduino\\_Mainframe\\Sen_Gnss.ino" 3
     ); &__c[0];}))
# 49 "d:\\Projects\\ArcticRover\\src\\arduino\\_Mainframe\\Sen_Gnss.ino"
     ))); Serial.println((reinterpret_cast<const __FlashStringHelper *>(
# 49 "d:\\Projects\\ArcticRover\\src\\arduino\\_Mainframe\\Sen_Gnss.ino" 3
     (__extension__({static const char __c[] __attribute__((__progmem__)) = (
# 49 "d:\\Projects\\ArcticRover\\src\\arduino\\_Mainframe\\Sen_Gnss.ino"
     " ms"
# 49 "d:\\Projects\\ArcticRover\\src\\arduino\\_Mainframe\\Sen_Gnss.ino" 3
     ); &__c[0];}))
# 49 "d:\\Projects\\ArcticRover\\src\\arduino\\_Mainframe\\Sen_Gnss.ino"
     )));
      millisGnssTestStart = millis();
      gnssTestState++;
      break;
    case 1:
      if (millis() - millisLastGnssPrint > 500) {
        millisLastGnssPrint = millis();
        QueryGnss();
      }

      if (millis() - millisGnssTestStart > 10000) gnssTestState++;
      break;
    case 2:
      SetStatus(12, GnssTime(true));
      gnssTestState = 0;
      testDone = true;
      BlackBoxAppendln((reinterpret_cast<const __FlashStringHelper *>(
# 65 "d:\\Projects\\ArcticRover\\src\\arduino\\_Mainframe\\Sen_Gnss.ino" 3
     (__extension__({static const char __c[] __attribute__((__progmem__)) = (
# 65 "d:\\Projects\\ArcticRover\\src\\arduino\\_Mainframe\\Sen_Gnss.ino"
     "------------------------------------"
# 65 "d:\\Projects\\ArcticRover\\src\\arduino\\_Mainframe\\Sen_Gnss.ino" 3
     ); &__c[0];}))
# 65 "d:\\Projects\\ArcticRover\\src\\arduino\\_Mainframe\\Sen_Gnss.ino"
     ))); Serial.println((reinterpret_cast<const __FlashStringHelper *>(
# 65 "d:\\Projects\\ArcticRover\\src\\arduino\\_Mainframe\\Sen_Gnss.ino" 3
     (__extension__({static const char __c[] __attribute__((__progmem__)) = (
# 65 "d:\\Projects\\ArcticRover\\src\\arduino\\_Mainframe\\Sen_Gnss.ino"
     "------------------------------------"
# 65 "d:\\Projects\\ArcticRover\\src\\arduino\\_Mainframe\\Sen_Gnss.ino" 3
     ); &__c[0];}))
# 65 "d:\\Projects\\ArcticRover\\src\\arduino\\_Mainframe\\Sen_Gnss.ino"
     )));
    default:
      break;
  }

  return testDone;
}
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
