Aarhus-University-MPE/ArcticRover/src/arduino/_Mainframe/Sys_Power.ino

/*
  GeoRover Power control

  Mads Rosenhøj Jeppesen
  Aarhus University
  2021
*/

// BatteryReading = 19.2 kOhm / (19.2 kOhm + 110 kOhm) * Battery Voltage
// 3.567 V -> ~5V ... 730 -> 1022 (int)
// 24.0 V -> 33.6 V
const int batteryLevelVoltage[] = {1022, 1004, 986, 956, 931, 920, 913, 898, 883, 839, 730};
const int batteryLevelPct[]     = {100, 98, 95, 90, 80, 60, 40, 25, 15, 5, 1};
//                            33.6, 33.0, 32.4, 31.44, 30.6, 30.24, 30.0, 29.52, 29.04, 27.6, 24.0

bool charge;  // Battery Charge status

// Checks voltage levels above critical values?
bool VoltageCheck() {
  return BatteryLevel() > BATTERY_STD_CHARGE;
}

bool BatteryStatus() {
  return VoltageCheck();
}

bool BatteryStatus(bool print) {
  if (!print) {
    return VoltageCheck();
  }

  DEBUG_PRINT(F("Battery Level: "));
  DEBUG_PRINTLN(BatteryLevel());

  DEBUG_PRINT(F("Battery Voltage: "));
  DEBUG_PRINTLN(BatteryVoltage());
  return VoltageCheck();
}

int BatteryLevel() {
  int voltage = analogRead(PA_SENSOR_BATT);

  int i = 0;

  while (voltage < batteryLevelVoltage[i]) {
    i++;
    if (i > 10) return 0;
  }

  return batteryLevelPct[i];
}

float BatteryVoltage() {
  int voltageInt = analogRead(PA_SENSOR_BATT);

  float voltageRead = voltageInt * 5.0f / 1024.0f;

  float voltageBattery = voltageRead * 129.2f / 19.2f;

  return voltageBattery;
}

/*
  Power Cycle Algorithm:
    if current power level (CPL) < min Level -> Set standby (start charging)
    if currently on charging and CPL > BATTERY_STD_RECHARGE, awake from standby
*/
bool PowerCycle() {
  int batteryLevel = BatteryLevel();

  if (!charge) {
    if (batteryLevel >= BATTERY_STD_RECHARGE) {
      DEBUG_PRINTLINE();
      DEBUG_PRINTLN(F("Battery Recharged to > 80%"));
      DEBUG_PRINTLINE();
      charge = true;
    }
  }

  if (charge && batteryLevel <= BATTERY_STD_CHARGE) {
    DEBUG_PRINTLINE();
    DEBUG_PRINTLN(F("Battery Level < 20%, starting charge cycle"));
    DEBUG_PRINTLINE();
    charge = false;
  }

  return charge;
}

void ResetPowerCycle() {
  charge = true;
}
