Aarhus-University-MPE/ArcticRover/src/arduino/_Mainframe/St_SystemTest.ino

/*  Strategy - System Test mode
    
    Runs system test...
*/

// Start sequence of strategy
void StartStrategySystemTest() {
  DEBUG_PRINT("Strategy: System Test starting...");
  DBG_ONLY(delay(500));
  
  delay(20);
  

}

// Main sequence of strategy
void RunStrategySystemTest() {
  // Blink light
  
}

// End sequence of strategy
void FinishStrategySystemTest() {
  DEBUG_PRINTLN("Strategy: System Test ending.");
  
  // Disable light
}
