Aarhus-University-MPE/ArcticRover/(commit log)

2021-05-18 State machine and sensor setup
2021-08-16 Button Functionalities
2022-01-27 CANBus system test
2022-02-01 Motor Controller - CAN bus
2022-02-03 Motor Class Implementation
2022-02-04 Motor TX period
2022-02-07 PCB Restructure and Motor Controller
2022-02-08 Sys Test , Sys Control and Module rework
    [Sen_Temp.ino, Str_SystemTest.ino, Sys_Control.ino, Sys_Heartbeat.ino, Sys_Motors.ino, _constants.h]
2022-02-09 System Test Non-blocking Rework
    [Com_CanBus.ino, Com_SBus.ino, Com_USB.ino, Sen_Accel.ino, Sen_Gnss.ino, Sen_Temp.ino, Str_SystemTest.ino, Sys_Blackbox.ino]
2022-03-11 Primary functions refactoring and memory optimization
    Reworked all constant strings to use F() macro, moving strings to PROGMEM freeing RAM.
    [ArcticRover.cpp, ArcticRover.h, Com_CanBus.ino, Com_Iridium.ino, Com_SBus.ino, Com_USB.ino, GemMotor.cpp, GemMotor.h]
2022-03-21 Torque Control RF
2022-03-22 Minor Remote Control Rework
    - Added speedcontrol to left stick
    [Com_CanBus.ino, Com_SBus.ino, GemMotor.cpp, Sys_StatusLED.ino, _constants.h]
2022-03-23 kiCad + Docs Folder
2022-03-24 Autonomy, SD/EEPROM pre-run checks
    Pathchecker implemented.
    Checks waypoint.csv on SD card, format and ranges between waypoints.
    Compares path on SD card to EEPROM path, flashes EEPROM with SD values if not similar.
    Added MotorCycle (runs CANcommand until both errors report no error or timesout (5sec))
    [Waypoints.csv]
2022-03-30 Cpp src folder, EEPROM waypoint load/set
    [Blackbox.csv, Waypoints_Example.csv]
2022-04-05 Minor Cleanup
    Fixed Motor accidentally enabled during Check process
    Temporarily removed Remote Control Strategy Disable features (when errors occur) to debug new PCB.
    Motor Supply Power error resulted in unresponsive motors.
    - Temporary constant 12VDC soldered.
    - Adding Capacitor might help and allow ZVP2110A to sufficiently supply motor driver with power.
    [Waypoints_Example.csv]
2022-04-07 LED Rework + Remote control debugging
    [Com_CanBus.ino, Com_SBus.ino, GemMotor.cpp, GemMotor.h, Str_ModeLibrary.ino, Sys_Autonomy.ino]
2022-04-19 Autonomy Documentation
    [Waypoints.csv]
2022-04-25 Major Remote Control And System Refactoring
    Cleaned up minor subsystems,
    Added SD File stream writing
    Cleaned up Button Debounce Functions
2022-04-27 Field Test with CPH University
    Minor motor driver reworks
    [Waypoints.csv]
2022-04-27 Remote control damping
    [Waypoints.csv]
2022-05-02 Autonomy Field Test Tune-in
    [Waypoints.csv]
2022-05-23 Minor Comments
    [Waypoints.csv]
